uiuiiii1/stm32f407-iot-gateway/docs/工业网关项目开发计划.md

# 基于RTOS的多功能工业网关 — 完整开发计划

> 本文档面向开发者与AI助手，包含全部器件清单、用途、接线方案、分阶段开发步骤与验证标准。
> 主控：STM32F407VGT6（Cortex-M4F，168MHz，1MB Flash，192KB SRAM）
> 系统：FreeRTOS 多任务
>
> **v1.1修订说明（2026-09-29）**：修正DS1307供电电平（必须接5V）、TJA1050电平说明（按数据手册VIH≥2.0V，可直连）、SD卡容量说法、内部Flash分区止址（1MB实际到0x080FFFFF）；修正FreeRTOS队列双消费者设计、SPI互斥锁范围、OTA双槽回滚、Flash写指针磨损方案；新增补购器件清单（B1~B5）、CubeMX关键设置（Serial Wire调试、HAL时基移TIM）、W5500/FreeRTOS整合坑、断网缓存容量与寿命核算；时间估算整体上调。

---

## 第一部分：器件清单与用途

### 一、已购全部器件（18项）

| 编号 | 器件名称 | 型号/规格 | 数量 | 核心用途 | 接口类型 |
|---|---|---|---|---|---|
| M1 | 主控核心板 | STM32F407VGT6（排针已焊） | 1 | 运行FreeRTOS，处理所有协议与任务 | — |
| M2 | 显示屏 | 1.54寸 TFT（配套核心板，SPI接口） | 1 | 本地显示IP、温湿度、运行状态、数据曲线 | SPI |
| M3 | 以太网模块 | W5500（普通版，硬件TCP/IP协议栈） | 1 | 接路由器，TCP/MQTT上传数据到云端 | SPI |
| M4 | RS485收发模块 | ZY-SP3485（3.3V） | 1 | 主控TTL电平 ↔ RS485差分信号转换 | UART + GPIO |
| M5 | 温湿度变送器 | 导轨式 RS485 Modbus RTU（SHT30方案） | 1 | 采集真实温湿度数据，作为Modbus从站 | RS485总线 |
| M6 | RTC时钟模块 | DS1307（带电池，I2C接口） | 1 | 为每条采集数据打时间戳，掉电持续走时（**VCC必须接5V**，见M6详述） | I2C |
| M7 | 外部Flash | W25Q64（8MB，SPI接口） | 1 | 断网数据缓存 + OTA固件备份存储 | SPI |
| M8 | USB转TTL | CH340模块 | 1 | 程序下载/串口调试，连接电脑与主控UART | UART（USB端） |
| M9 | 杜邦线 | 公对母/母对母 | 1扎 | 模块间接线 | — |
| M10 | 面包板 | 830孔 | 1块 | 临时搭建电路，模块互连 | — |
| M11 | 电源适配器 | 5V 2A | 1个 | 整套系统供电（阶段0~10够用；做4G双链路时建议换5V 3A，见补购B5） | DC |
| M12 | 网线 | 超五类 | 1根 | W5500连接路由器或电脑 | RJ45 |
| M13 | 120Ω电阻 | 1/4W 1%金属膜 | 2个 | CAN/RS485总线终端电阻（阻抗匹配） | 直插 |
| M14 | CAN收发器 | TJA1050模块 | 1 | 主控CAN外设 ↔ CAN差分总线转换（可选扩展） | CAN + GPIO |
| M15 | USB转RS485 | CH340方案（无隔离基础款） | 1 | 电脑端直接发Modbus指令调试温湿度变送器 | USB（电脑端） |
| M16 | SD卡模块 | 5V版（带电平转换，支持SDHC） | 1 | 大量历史数据本地存储（数据黑匣子，可选） | SPI |
| M17 | SD卡 | 8G/16G Class10（FAT32格式） | 1张 | 配合SD卡模块存储历史采集数据 | — |
| M18 | 4G模块 | Air780E开发板 | 1 | 无以太网时4G上云，双链路备份（可选扩展） | UART |

### 二、还需补购的器件（未购，v1.1新增）

| 编号 | 器件 | 参考价 | 必要性 | 用途 |
|---|---|---|---|---|
| B1 | ST-Link V2调试器（或DAPLink） | ¥20~30 | **必买** | SWD下载+在线调试。没有它无法设断点、无法查任务栈水位（uxTaskGetStackHighWaterMark），FreeRTOS整合阶段（阶段8）基本靠猜 |
| B2 | 逻辑分析仪（24MHz/8通道入门款即可） | ¥30~60 | 强烈推荐 | 抓SPI/I2C/RS485波形，定位DE/RE切换时序、SPI共享总线仲裁问题，一次投入全程受益 |
| B3 | DS3231 RTC模块 | ¥10~15 | 可选备件 | DS1307模块5V供电仍异常时直接替换（精度还高一个数量级） |
| B4 | 物联网SIM卡（移动/电信流量卡即可） | 按需 | 阶段13需要 | Air780E 4G上云 |
| B5 | 5V 3A电源适配器 | ¥15 | 阶段13需要 | 4G射频发射峰值1~2A，2A适配器余量不足 |

> 已购器件使用前核对：SP3485/W5500/W25Q64/TFT屏为3.3V器件；SD卡模块为5V版；**DS1307模块按5V接线（见M6修正）**；变送器5~28V宽压接5V。**温湿度变送器的Modbus寄存器地址表务必开工前向商家索要，没有它阶段3无法解析数据。**

### 三、各器件详细用途说明

#### M1 STM32F407VGT6 核心板
- **定位**：整个系统的大脑，运行FreeRTOS实时操作系统
- **关键资源**：1MB Flash（存Bootloader+应用+OTA备份）、192KB SRAM（任务栈+缓冲区）、3路SPI、3路UART、2路I2C、1路CAN、1路FSMC
- **板载资源**：Type-C供电口、复位按键、BOOT选择按键、LCD接口座、引出全部IO引脚
- **注意**：BOOT0接GND为正常Flash启动，BOOT0接3.3V为ISP串口下载模式

#### M2 1.54寸 TFT 显示屏
- **定位**：本地人机界面，替代原计划的0.96寸OLED
- **典型参数**：240×240分辨率，ST7789或ST7735驱动IC，SPI接口，65K色（RGB565）
- **显示内容规划**：
  - 第1行：系统标题 + 运行状态（在线/离线/采集中）
  - 第2行：IP地址
  - 第3行：温度值 + 单位
  - 第4行：湿度值 + 单位
  - 第5行：RTC时间
  - 第6行：网络状态 + 缓存数据条数
- **接口引脚**：BL（背光）、CS（片选）、DC（数据/命令选择）、SDA（MOSI）、SCL（SCK）、RST（复位）、GND、VCC（3.3V）

#### M3 W5500 以太网模块
- **定位**：硬件TCP/IP协议栈，减轻MCU负担，实现联网上云
- **关键特性**：全硬件TCP/IP（TCP/UDP/ICMP/IPv4/ARP），8个独立Socket，SPI接口，3.3V供电
- **用途**：通过MQTT或HTTP协议将采集的温湿度数据上传到云端服务器（如阿里云IoT、腾讯云IoT、或自建MQTT broker）
- **注意**：W5500芯片是3.3V器件（常见模块板载LDO可接受5V输入，按实物确认，严禁把5V直接接到芯片侧引脚）；SPI速率策略：初始化先降到3MHz以下，读到版本寄存器VERSIONR（0x0019）=0x04确认SPI链路正常后再逐步提速；**面包板+杜邦线走线下14MHz左右是实际稳定上限，80MHz只适合PCB短走线，本项目按14MHz封顶**

#### M4 SP3485 RS485收发模块
- **定位**：TTL电平 ↔ RS485差分信号的转换桥梁
- **关键引脚**：VCC（3.3V）、GND、TX（接MCU RX）、RX（接MCU TX）、DE/RE（收发方向控制，接MCU GPIO）
- **工作模式**：
  - DE=1, RE=1 → 发送模式（MCU向总线发数据）
  - DE=0, RE=0 → 接收模式（MCU从总线收数据）
- **注意**：必须买3.3V版本，5V的MAX485与F407电平不匹配

#### M5 温湿度变送器（RS485 Modbus RTU从站）
- **定位**：真实工业传感器，提供温湿度数据源
- **通信协议**：Modbus RTU，作为从站响应主站（网关）的读寄存器指令
- **典型寄存器**（需向商家确认具体地址表）：
  - 温度寄存器：通常地址0x0000，值=实际温度×10（如25.5℃→0x00FF=255）
  - 湿度寄存器：通常地址0x0001，值=实际湿度×10
- **供电**：5~28V宽压，项目中接5V
- **默认参数**：波特率9600，数据位8，停止位1，无校验，从站地址0x01（需向商家确认）

#### M6 DS1307 RTC时钟模块
- **定位**：实时时钟，为采集数据提供精确时间戳
- **关键特性**：I2C接口，7位地址0x68（8位写0xD0/读0xD1），带CR2032电池掉电走时，BCD码计时
- **用途**：每条温湿度数据附带年月日时分秒，断网缓存时按时间排序，联网补传时按时间顺序发送
- **⚠️ 供电修正（v1.1）**：**模块VCC必须接5V，不能接3.3V**。DS1307手册规定VCC=4.5~5.5V，且VCC低于约1.25×VBAT（CR2032为3V，即约3.75V）时芯片进入电池备份模式、I2C完全无响应。F407的PB6/PB7是FT（5V tolerant）引脚，模块上拉到5V的I2C总线可直接连接，无需电平转换。
- **注意**：DS1307精度一般（月误差±几分钟），项目够用；I2C上拉电阻模块通常已自带。若模块5V供电仍工作异常，换DS3231模块（3.3V/5V通用、温补晶振年误差约1分钟、寄存器与DS1307高度相似，见补购清单B3）

#### M7 W25Q64 外部Flash
- **定位**：8MB串行Flash，用于数据持久化存储
- **分区规划**（v1.1与阶段10双槽方案对齐）：
  - 扇区0（4KB）：配置参数区（云端地址、设备ID、波特率等）
  - 扇区1~255（约1MB）：断网数据缓存区（循环写入，磨损均衡）
  - 扇区256~383（512KB）：OTA新固件下载区
  - 扇区384~511（512KB）：OTA旧固件备份区（升级前备份当前应用，用于回滚）
  - 扇区512~2047（约6MB）：预留扩展（可借给数据缓存区扩容）
- **关键特性**：SPI接口，24位地址，扇区擦除（4KB），页编程（256字节），JEDEC ID 0xEF4017
- **注意**：W25Q64是3.3V器件

#### M8 CH340 USB转TTL
- **定位**：电脑与主控之间的串口通信桥梁
- **用途**：
  - 程序下载（配合FlyMcu或Keil的ISP下载）
  - 串口调试打印（printf输出运行日志、变量值、错误信息）
- **接线**：CH340 TXD → 主控 UART1 RX（PA10），CH340 RXD → 主控 UART1 TX（PA9），GND共地
- **注意**：TX/RX要交叉连接；CH340的3.3V/5V输出不要给整个系统供电，仅做信号

#### M14 TJA1050 CAN收发器
- **定位**：CAN控制器（F407片上bxCAN）↔ CAN差分总线的物理层转换
- **关键引脚**：VCC（5V）、GND、TXD（接MCU CAN_TX）、RXD（接MCU CAN_RX）、CANH、CANL
- **用途**：可选扩展，采集CAN总线设备数据（如汽车OBD、工业PLC），车企/工控方向常见应用
- **注意**：TJA1050是5V供电；其TXD输入为TTL电平（数据手册VIH≥2.0V），F407的3.3V推挽输出可直接驱动；RXD输出高电平接近5V，接PA11——F407的FT（5V tolerant）引脚，可直接连接，无需电平转换；总线两端各接120Ω终端电阻

#### M16 SD卡模块（5V版）
- **定位**：大容量本地存储，用于"数据黑匣子"功能
- **关键特性**：5V供电（板载电平转换芯片），SPI接口，支持SDHC卡（≤32GB）
- **用途**：存储历史采集数据，可按天/按文件存储，支持FatFS文件系统
- **注意**：本项目用5V版模块（板载LDO+电平转换），按5V接线最稳妥；SD/SDHC卡本身一律是3.3V信号，"≤2GB的SD卡与2~32GB的SDHC"只是卡容量规格差异、与模块供电无关（v1.1修正）；SD卡必须格式化为FAT32（FatFS默认不支持exFAT，除非开启FF_FS_EXFAT）

#### M18 Air780E 4G模块
- **定位**：以太网不可用时的备用上云通道，双链路冗余
- **关键特性**：Cat.1 bis，UART AT指令控制，支持MQTT/TCP/HTTP，需要物联网SIM卡
- **供电**：射频发射峰值1~2A，不能靠开发板USB供电；建议整机换5V 3A适配器（见补购B5），模块电源引脚就近并联≥470µF电容——供电不足的典型症状是MQTT连上后反复掉线重启
- **用途**：检测到W5500网络断开且持续无法恢复时，自动切换到4G链路上传数据
- **注意**：4G模块是可选高级功能，项目后期再做；需要单独购买物联网SIM卡（移动/电信）

---

## 第二部分：硬件连接方案

### 一、主控引脚分配总表

| 外设 | 功能 | MCU引脚 | 备注 |
|---|---|---|---|
| **UART1** | 调试串口（接CH340） | PA9(TX), PA10(RX) | printf调试输出 |
| **UART2** | RS485（接SP3485） | PA2(TX), PA3(RX) | Modbus RTU主站 |
| **UART2_DIR** | RS485收发方向控制 | PA4 | 高=发送，低=接收 |
| **UART3** | 4G模块（接Air780E） | PB10(TX), PB11(RX) | 可选，后期使用 |
| **SPI1** | W5500以太网 | PA5(SCK), PA6(MISO), PA7(MOSI) | 硬件TCP/IP |
| **SPI1_CS_W5500** | W5500片选 | PC4 | 低有效 |
| **SPI1_RST_W5500** | W5500复位 | PC5 | 低复位 |
| **SPI1_INT_W5500** | W5500中断 | PB0 | 可选，用于Socket事件通知 |
| **SPI2** | W25Q64 Flash | PB13(SCK), PB14(MISO), PB15(MOSI) | 外部存储 |
| **SPI2_CS_FLASH** | W25Q64片选 | PB12 | 低有效 |
| **SPI3** | 1.54寸TFT屏 | PB3(SCK), PB4(MISO), PB5(MOSI) | 显示输出 |
| **SPI3_CS_LCD** | TFT屏片选 | PA15 | 低有效 |
| **LCD_DC** | TFT数据/命令选择 | PB6 | 低=命令，高=数据 |
| **LCD_RST** | TFT复位 | PB7 | 低复位 |
| **LCD_BL** | TFT背光控制 | PB8 | 高=背光开 |
| **I2C1** | DS1307 RTC | PB8(SCL), PB9(SDA) | 实时时钟 |
| **CAN1** | TJA1050 CAN收发器 | PA11(RX), PA12(TX) | 可选扩展 |
| **LED** | 板载/外接状态LED | PC13 | 心跳指示灯 |
| **KEY** | 用户按键 | PC0 | 可选，手动触发补传/配网 |

> **注意**：PB8同时被LCD_BL和I2C1_SCL占用，需要调整。将I2C1改为PB6(SCL)/PB7(SDA)，LCD_BL改为PB9。修正后的引脚分配见下方最终版。

### 二、修正后的最终引脚分配（无冲突）

| 外设 | 功能 | MCU引脚 | 方向 |
|---|---|---|---|
| UART1 | 调试串口 | PA9(TX), PA10(RX) | 复用 |
| UART2 | RS485 | PA2(TX), PA3(RX) | 复用 |
| UART2_DIR | RS485方向控制 | PA4 | 输出 |
| UART3 | 4G模块（可选） | PB10(TX), PB11(RX) | 复用 |
| SPI1 | W5500 | PA5(SCK), PA6(MISO), PA7(MOSI) | 复用 |
| W5500_CS | 片选 | PC4 | 输出 |
| W5500_RST | 复位 | PC5 | 输出 |
| W5500_INT | 中断（可选） | PB0 | 输入 |
| SPI2 | W25Q64 + SD卡 | PB13(SCK), PB14(MISO), PB15(MOSI) | 复用 |
| FLASH_CS | W25Q64片选 | PB12 | 输出 |
| SD_CS | SD卡片选 | PC6 | 输出 |
| SPI3 | 1.54寸TFT | PB3(SCK), PB4(MISO未用), PB5(MOSI) | 复用 |
| LCD_CS | 屏片选 | PA15 | 输出 |
| LCD_DC | 数据/命令 | PB6 | 输出 |
| LCD_RST | 屏复位 | PB7 | 输出 |
| LCD_BL | 背光 | PB8 | 输出 |
| I2C1 | DS1307 | PB8(SCL), PB9(SDA) → **冲突！** | — |

> **再次修正**：PB8被LCD_BL占用，I2C1不能用PB8/PB9。
> **最终方案**：I2C1 使用 PB6(SCL)/PB7(SDA)，LCD_DC 改用 PC7，LCD_RST 改用 PC8，LCD_BL 改用 PC9。

### 三、最终无冲突引脚分配（请以此为准）

| 外设 | 功能 | MCU引脚 | 方向 | 说明 |
|---|---|---|---|---|
| **UART1** | 调试串口（CH340） | PA9(TX), PA10(RX) | AF7 | printf日志 |
| **UART2** | RS485（SP3485） | PA2(TX), PA3(RX) | AF7 | Modbus主站 |
| RS485_DIR | 收发方向控制 | PA4 | OUT | 1=发,0=收 |
| **UART3** | 4G模块（Air780E） | PB10(TX), PB11(RX) | AF7 | 可选/后期 |
| **SPI1** | W5500以太网 | PA5(SCK),PA6(MISO),PA7(MOSI) | AF5 | 硬件TCP/IP |
| W5500_CS | 片选 | PC4 | OUT | 低有效 |
| W5500_RST | 复位 | PC5 | OUT | 低复位 |
| W5500_INT | 中断 | PB0 | IN | 可选 |
| **SPI2** | W25Q64 + SD卡 | PB13(SCK),PB14(MISO),PB15(MOSI) | AF5 | 共用总线 |
| FLASH_CS | W25Q64片选 | PB12 | OUT | 低有效 |
| SD_CS | SD卡片选 | PC6 | OUT | 低有效 |
| **SPI3** | 1.54寸TFT屏 | PB3(SCK),PB5(MOSI) | AF6 | MISO可不接 |
| LCD_CS | 屏片选 | PA15 | OUT | 低有效 |
| LCD_DC | 数据/命令选择 | PC7 | OUT | 0=命令,1=数据 |
| LCD_RST | 屏复位 | PC8 | OUT | 低复位 |
| LCD_BL | 背光控制 | PC9 | OUT | 1=开 |
| **I2C1** | DS1307 RTC | PB6(SCL), PB7(SDA) | AF4 | 7位地址0x68；**模块VCC接5V**（PB6/PB7为FT引脚可承受） |
| **CAN1** | TJA1050（可选） | PA11(RX), PA12(TX) | AF9 | 车企加分 |
| LED | 心跳灯 | PC13 | OUT | 板载LED |
| KEY | 用户按键 | PC0 | IN | 可选 |

> **⚠️ CubeMX必设项（v1.1新增）**：SYS → Debug 必须选 **Serial Wire**。默认状态下PB3/PB4是JTAG的JTDO/NJTRST，不释放的话SPI3的TFT屏怎么调都不出图；且只有选了Serial Wire才能用ST-Link下载与断点调试。

### 四、各模块详细接线表

#### 1. CH340 USB转TTL ↔ STM32（调试串口）

| CH340引脚 | STM32引脚 | 说明 |
|---|---|---|
| GND | GND | 共地（必须） |
| TXD | PA10（UART1_RX） | 交叉连接 |
| RXD | PA9（UART1_TX） | 交叉连接 |
| 3.3V/5V | **不接** | 不要用CH340给系统供电 |

#### 2. SP3485 ↔ STM32 ↔ 温湿度变送器

| SP3485引脚 | STM32引脚 | 说明 |
|---|---|---|
| VCC | 3.3V | 3.3V供电（关键！不要接5V） |
| GND | GND | 共地 |
| TX | PA3（UART2_RX） | SP3485发送→MCU接收 |
| RX | PA2（UART2_TX） | MCU发送→SP3485接收 |
| DE/RE | PA4 | 方向控制，短接在一起 |

| 温湿度变送器 | SP3485侧 | 说明 |
|---|---|---|
| VCC+ | 5V | 变送器5~28V宽压，接5V |
| GND | GND | 共地 |
| 485A | A | RS485 A线 |
| 485B | B | RS485 B线 |

> **RS485总线终端电阻**：仅1个从站、线短（<1m）时可不接；长距离时在总线两端各接1个120Ω（A-B之间）。

#### 3. W5500 ↔ STM32

| W5500引脚 | STM32引脚 | 说明 |
|---|---|---|
| VCC | 3.3V | 3.3V供电（关键！不要接5V） |
| GND | GND | 共地 |
| SCK | PA5（SPI1_SCK） | SPI时钟 |
| MISO | PA6（SPI1_MISO） | 主入从出 |
| MOSI | PA7（SPI1_MOSI） | 主出从入 |
| CS | PC4 | 片选，低有效 |
| RST | PC5 | 复位，低有效 |
| INT | PB0 | 中断输出（可选，不接也能用） |

#### 4. W25Q64 ↔ STM32

| W25Q64引脚 | STM32引脚 | 说明 |
|---|---|---|
| VCC | 3.3V | 3.3V供电 |
| GND | GND | 共地 |
| CLK | PB13（SPI2_SCK） | SPI时钟 |
| DO(MISO) | PB14（SPI2_MISO） | 数据输出 |
| DI(MOSI) | PB15（SPI2_MOSI） | 数据输入 |
| CS | PB12 | 片选，低有效 |
| WP/HOLD | 3.3V | 接高电平，不使用写保护/暂停 |

#### 5. SD卡模块（5V版）↔ STM32

| SD卡模块引脚 | STM32引脚 | 说明 |
|---|---|---|
| VCC | 5V | 5V供电（模块自带电平转换） |
| GND | GND | 共地 |
| SCK | PB13（SPI2_SCK） | 与W25Q64共用SCK |
| MISO | PB14（SPI2_MISO） | 与W25Q64共用MISO |
| MOSI | PB15（SPI2_MOSI） | 与W25Q64共用MOSI |
| CS | PC6 | 独立片选，低有效 |

> **SPI2总线**：W25Q64和SD卡共用SCK/MISO/MOSI，通过不同CS引脚区分。同一时刻只能有一个设备CS为低。

#### 6. 1.54寸 TFT屏 ↔ STM32

| TFT屏引脚 | STM32引脚 | 说明 |
|---|---|---|
| VCC | 3.3V | 3.3V供电 |
| GND | GND | 共地 |
| SCL | PB3（SPI3_SCK） | SPI时钟 |
| SDA | PB5（SPI3_MOSI） | 数据输入（TFT只收不发） |
| CS | PA15 | 片选，低有效 |
| DC | PC7 | 0=发命令，1=发数据 |
| RST | PC8 | 复位，低有效 |
| BL | PC9 | 背光控制，1=开 |

> 注意：TFT屏的MISO引脚通常不需要接（屏只接收数据不发送），如果屏上有此引脚可悬空。

#### 7. DS1307 RTC ↔ STM32

| DS1307引脚 | STM32引脚 | 说明 |
|---|---|---|
| VCC | 5V | **必须接5V**（DS1307手册VCC=4.5~5.5V；接3.3V时芯片因掉电检测阈值进入电池模式，I2C无响应） |
| GND | GND | 共地 |
| SCL | PB6（I2C1_SCL） | I2C时钟 |
| SDA | PB7（I2C1_SDA） | I2C数据 |

> DS1307模块通常已自带4.7K上拉电阻（上拉到模块VCC=5V；PB6/PB7为FT引脚，可承受5V总线电平，无需电平转换）。I2C 7位地址0x68（8位写0xD0/读0xD1）。

#### 8. TJA1050 CAN收发器 ↔ STM32（可选）

| TJA1050引脚 | STM32引脚 | 说明 |
|---|---|---|
| VCC | 5V | 5V供电 |
| GND | GND | 共地 |
| TXD | PA12（CAN1_TX） | MCU发送 |
| RXD | PA11（CAN1_RX） | MCU接收 |
| CANH | CAN总线H | 接CAN总线 |
| CANL | CAN总线L | 接CAN总线 |
| S | GND | 工作模式（接地=正常模式） |

> CAN总线两端各接1个120Ω终端电阻（CANH-CANL之间）。仅两个节点时两个节点各焊一颗。

#### 9. Air780E 4G模块 ↔ STM32（可选/后期）

| Air780E引脚 | STM32引脚 | 说明 |
|---|---|---|
| VCC | 5V（建议整机3A适配器，模块就近并联≥470µF电容） | 射频发射峰值1~2A，供电不足会反复掉线重启 |
| GND | GND | 共地 |
| TXD | PB11（UART3_RX） | 模块发送→MCU接收 |
| RXD | PB10（UART3_TX） | MCU发送→模块接收 |
| PWR_KEY | GPIO（如PC10） | 开机控制（拉低2秒开机） |
| RESET | GPIO（如PC11） | 复位（可选） |

> Air780E需要插入物联网SIM卡，默认波特率115200。

### 五、供电方案

```
5V 2A电源适配器
    ├── 5V → 温湿度变送器 VCC
    ├── 5V → SD卡模块 VCC
    ├── 5V → TJA1050 VCC
    ├── 5V → Air780E VCC（独立供电，峰值1A）
    └── 5V → STM32核心板 Type-C或5V引脚（板载AMS1117转3.3V）
                                          ├── 3.3V → W5500 VCC
                                          ├── 3.3V → SP3485 VCC
                                          ├── 3.3V → W25Q64 VCC
                                          ├── 3.3V → DS1307 VCC
                                          ├── 3.3V → TFT屏 VCC
                                          └── 3.3V → 各模块上拉电阻
```

> **关键**：所有模块GND必须连在一起（共地），否则通信异常。5V 2A电源是必须的，USB供电电流不够。
> **v1.1补充**：W5500的3.3V由核心板同一颗AMS1117提供——单LDO供电天然规避了VDD/VDDA分路LDO上电时序不一致引起的W5500冷启动概率性初始化失败，这个接法不要改成模块独立供电。阶段0~10用2A适配器足够，做阶段13（4G）时换5V 3A（补购B5）。

---

## 第三部分：开发环境搭建

### 一、软件清单

| 软件 | 用途 | 版本建议 | 下载来源 |
|---|---|---|---|
| Keil MDK-ARM | 代码编写、编译、调试 | V5.38或V5.39 | Keil官网（需注册License） |
| STM32CubeMX | 图形化配置GPIO/外设/时钟，生成初始化代码 | 最新版 | ST官网 |
| STM32CubeF4固件库 | F4系列HAL库/标准外设库 | 最新版 | ST官网 |
| FlyMcu | 串口ISP下载程序 | V0.188 | 网上搜索 |
| 串口助手 | 调试串口打印 | XCOM或SSCOM | 网上搜索 |
| Modbus Poll / 串口调试助手 | 电脑端通过USB转RS485发Modbus指令测试变送器 | Modbus Poll | 网上搜索 |
| MQTTX（或MQTT.fx 1.7） | 电脑端MQTT客户端，模拟云端接收数据 | MQTTX免费开源，推荐 | EMQ官网/GitHub |
| 文本编辑器 | 查看/编辑代码 | VS Code | 微软官网 |

### 二、Keil工程创建步骤

1. 打开STM32CubeMX，新建项目，选择MCU为STM32F407VGTx
2. 配置系统时钟：HSE（外部晶振，通常8MHz或25MHz，看核心板原理图），PLL倍频至168MHz
3. 按"最终无冲突引脚分配表"配置每个外设的GPIO和复用功能；**SYS → Debug 必须选 Serial Wire**（否则PB3/PB4被JTAG占用，SPI3的TFT屏不工作，也无法用ST-Link在线调试）
4. 配置UART1：115200波特率，8数据位，1停止位，无校验
5. 配置UART2：9600波特率（匹配温湿度变送器默认值），8N1
6. 配置SPI1：主机模式，8位，CPOL=Low, CPHA=1Edge（W5500要求Mode0），预分频器初始设为64（2.625MHz），稳定后改2（42MHz）
7. 配置SPI2：主机模式，8位，Mode0，预分频器初始64
8. 配置SPI3：主机模式，8位，Mode0，预分频器初始64
9. 配置I2C1：标准模式100kHz或快速模式400kHz
10. 配置CAN1：500kbps（常用），工作模式正常
11. 配置GPIO输出：各CS、RST、DC、BL、DIR、LED
12. 生成代码（选择MDK-ARM V5）
13. 在Keil中打开生成的工程，添加FreeRTOS源码
14. 配置工程选项：C/C++ → Define 添加 USE_HAL_DRIVER, STM32F407xx；Optimization选-O1（调试阶段选-O0）
15. Debug → 选择ST-Link或J-Link（如果用调试器），或用FlyMcu串口下载

### 三、程序下载方式

| 方式 | 所需硬件 | 步骤 |
|---|---|---|
| ST-Link调试器 | ST-Link V2 | SWD接口（SWDIO=PA13, SWCLK=PA14），Keil直接下载+调试 |
| 串口ISP下载 | CH340 + FlyMcu | BOOT0接3.3V→复位→FlyMcu下载→BOOT0接GND→复位运行 |
| DAPLink | DAPLink调试器 | 同ST-Link，SWD接口 |

> 推荐：如果有ST-Link或DAPLink，用SWD下载，可以在线调试（设断点、看变量）。只有CH340的话用串口ISP下载，不能在线调试。

---

## 第四部分：分阶段开发计划

### 总体原则
- 从易到难，每一步先验证通过再进入下一步
- 每完成一个模块，保存一个可工作的工程备份
- 先裸机调通每个外设，再移植FreeRTOS整合
- 先核心功能（采集+显示+上传），后高级功能（缓存+OTA+4G+CAN）

---

### 阶段0：硬件验证与点灯（预计0.5天）

**目标**：确认核心板能正常下载程序、运行、串口输出。

**操作步骤**：
1. 核心板插Type-C供电（或5V引脚），确认电源灯亮
2. CH340接UART1（PA9/PA10），插电脑，确认设备管理器出现COM口
3. CubeMX生成最简工程（只配UART1 + GPIO PC13输出 + 系统时钟）
4. 在main.c中添加：LED闪烁（500ms周期）+ printf("System Start\r\n")
5. 编译、下载、运行
6. 串口助手收到"System Start"，LED闪烁 → 验证通过

**验证标准**：
- [ ] 程序能正常下载
- [ ] LED按预期闪烁
- [ ] 串口能收到printf输出
- [ ] 复位后重新运行正常

**常见问题**：
- 串口收不到：检查TX/RX是否交叉、GND是否共地、波特率是否一致
- 程序下载失败：检查BOOT0位置、CH340驱动、串口是否被占用

---

### 阶段1：1.54寸TFT屏显示（预计1天）

**目标**：屏幕能显示文字、数字、颜色填充。

**操作步骤**：
1. 按接线表连接TFT屏（SPI3：PB3/PB5，CS=PA15，DC=PC7，RST=PC8，BL=PC9）
2. 确认屏的驱动IC：查看商家资料，常见为ST7789（240×240）或ST7735（128×128/128×160）
3. 添加对应驱动文件（lcd.c/lcd.h），实现：
   - `LCD_Init()`：初始化序列（复位→发送初始化命令→开显示）
   - `LCD_Clear(color)`：全屏填充
   - `LCD_DrawPoint(x,y,color)`：画点
   - `LCD_ShowChar(x,y,ch,color,bg,size)`：显示单个ASCII字符
   - `LCD_ShowString(x,y,str,color,bg,size)`：显示字符串
   - `LCD_ShowNum(x,y,num,len,color,bg,size)`：显示数字
4. 字模数据：使用PCtoLCD2002取模软件生成ASCII字模（16×8或24×12），存入font.c
5. main.c中测试：清屏→显示"Gateway Test"→显示数字12345→显示IP"192.168.1.100"
6. 编译下载，观察屏幕

**验证标准**：
- [ ] 屏幕背光点亮
- [ ] 全屏填充颜色正常（无花屏、无偏移）
- [ ] 英文字符显示清晰、位置正确
- [ ] 数字显示正确
- [ ] 多次刷新不出现残影或错位

**常见问题**：
- 屏幕不亮：检查BL引脚是否拉高、VCC是否3.3V
- 花屏/白屏：SPI速率太高（降低预分频器）、RST时序不对、初始化命令不对
- 颜色反转/偏移：确认驱动IC型号（ST7789 vs ST7735），不同IC的初始化命令和扫描方向不同
- 字符乱码：字模取模方式与显示函数不匹配（逐行式/逐列式、正序/倒序）

---

### 阶段2：DS1307 RTC时间读取（预计0.5天）

**目标**：能读取并设置当前时间，串口打印正确时间。

**操作步骤**：
1. 连接DS1307（I2C1：PB6/PB7，**模块VCC接5V**），插入CR2032电池
2. CubeMX配置I2C1：100kHz标准模式
3. 实现ds1307.c/ds1307.h：
   - `DS1307_Init()`：检查器件是否响应（读地址0x00）
   - `DS1307_SetTime(y,m,d,h,min,s)`：设置时间（BCD码转换）
   - `DS1307_GetTime(&time)`：读取时间
   - BCD↔十进制转换函数
4. main.c中：设置一个时间→循环读取→串口打印"2026-09-29 12:00:00"
5. 断电10秒再上电，确认时间继续走（电池备份生效）

**验证标准**：
- [ ] I2C能扫描到DS1307地址（0x68）
- [ ] 设置时间后读取值一致
- [ ] 时间每秒递增正确
- [ ] 掉电后时间不丢失（电池供电）

**常见问题**：
- I2C扫描不到设备：检查SDA/SCL是否接反、上拉电阻是否存在、模块VCC是否接的5V（接3.3V时DS1307进入电池模式、I2C无响应，这是本模块最常见故障）
- 时间不走：检查CH位（寄存器0x00的bit7）是否为0（0=振荡器开启）
- 时间值异常：BCD码没有正确转换（DS1307寄存器存的是BCD码，不是二进制）

---

### 阶段3：RS485 Modbus采集温湿度（预计1.5天）

**目标**：通过RS485读取温湿度变送器数据，解析出温度和湿度值。

**操作步骤**：

#### 3.1 先用USB转RS485在电脑端验证变送器（必做！）
1. USB转RS485插入电脑，安装CH340驱动
2. USB转RS485的A/B接温湿度变送器的A/B，变送器接5V电源
3. 打开Modbus Poll或串口调试助手
4. 发送读保持寄存器指令（需根据商家提供的寄存器表）：
   - 典型指令：`01 03 00 00 00 02 C4 0B`
     - 01=从站地址，03=功能码（读保持寄存器），0000=起始地址，0002=寄存器数量，C40B=CRC16
   - 预期回复：`01 03 04 00 FF 01 02 XX XX`（温度25.5℃，湿度25.8%为例）
5. 确认变送器能正常回复数据，记录：从站地址、波特率、温度寄存器地址、湿度寄存器地址、数据换算公式

#### 3.2 STM32端实现Modbus RTU主站
1. 连接SP3485（UART2：PA2/PA3，DIR=PA4）
2. CubeMX配置UART2：9600波特率（或变送器实际波特率），8N1
3. 实现modbus.c/modbus.h：
   - `MODBUS_SendRead(slave_addr, reg_addr, reg_num)`：组装读寄存器指令+CRC16，DE拉高→发送；**等UART的TC（Transmission Complete）标志置位后再拉低DE切回接收**——盲等固定延时容易截断最后1~2字节，是RS485最经典的偶发丢包原因
   - `MODBUS_Receive(buf, timeout)`：等待从站回复，超时返回错误
   - `CRC16(data, len)`：Modbus CRC16校验算法（多项式0xA001）
   - `MODBUS_ReadTempHum(&temp, &hum)`：完整流程：发指令→收回复→CRC校验→解析数据→换算实际值
4. 数据解析：
   - 温度值 = 寄存器值 / 10.0（如果是放大10倍存储）
   - 湿度值 = 寄存器值 / 10.0
5. main.c中：每2秒读一次温湿度，串口打印"Temp: 25.5C, Hum: 60.2%"

**验证标准**：
- [ ] USB转RS485电脑端能读到变送器数据（确认变送器本身正常）
- [ ] STM32能发出正确的Modbus指令（可用USB转RS485在电脑端监听）
- [ ] STM32能收到变送器回复
- [ ] CRC校验通过
- [ ] 解析出的温湿度值合理（与电脑端读到的一致）
- [ ] 连续读取10次无丢包、无异常值

**常见问题**：
- 收不到回复：DE/RE方向控制时序不对（发完指令要延迟一小段再切回接收）、A/B线接反、波特率不匹配
- CRC校验失败：字节丢失（波特率误差大）、接收缓冲区溢出、从站地址错误
- 数据异常：寄存器地址不对、数据大小端搞反、换算公式不对（必须以商家提供的寄存器表为准）
- 偶尔丢包：RS485总线没有终端电阻（长距离时）、发送间隔太短（至少间隔100ms）

---

### 阶段4：W25Q64 Flash读写（预计1天）

**目标**：能对W25Q64进行读ID、擦除、写数据、读数据操作。

**操作步骤**：
1. 连接W25Q64（SPI2：PB13/PB14/PB15，CS=PB12）
2. 实现w25q64.c/w25q64.h：
   - `W25Q64_ReadID()`：发送0x9F命令，读取JEDEC ID（应为0xEF4017）
   - `W25Q64_WriteEnable()`：发送0x06命令
   - `W25Q64_WaitBusy()`：读状态寄存器1（0x05），等待BUSY位清零
   - `W25Q64_SectorErase(addr)`：扇区擦除（0x20命令，4KB对齐）
   - `W25Q64_PageProgram(addr, data, len)`：页编程（0x02命令，≤256字节）
   - `W25Q64_ReadData(addr, buf, len)`：读数据（0x03命令）
3. main.c中测试：
   - 读ID，确认是0xEF4017
   - 擦除扇区0
   - 写入测试数据"Hello W25Q64"
   - 读回数据，串口打印对比
4. 实现简单的存储管理：
   - 定义数据结构体：`{uint32_t timestamp; float temp; float hum; uint8_t status;}` 约13字节
   - `Flash_SaveData(data)`：追加写入缓存区
   - `Flash_ReadData(index, &data)`：读取指定位置数据
   - `Flash_GetDataCount()`：获取缓存数据条数

**验证标准**：
- [ ] JEDEC ID读取正确（0xEF4017）
- [ ] 擦除后读取全0xFF
- [ ] 写入后读回数据一致
- [ ] 跨页写入正常（写入>256字节时自动分页）
- [ ] 掉电后数据不丢失
- [ ] 连续写入100条数据后读取全部正确

**常见问题**：
- ID读不到：SPI模式不对（W25Q64用Mode0）、CS时序不对、SPI速率太高
- 写入失败：没有先发Write Enable命令、没有等待Busy结束、地址没有页对齐
- 数据不对：地址计算错误、大小端问题

---

### 阶段5：W5500以太网联网（预计2天）

**目标**：W5500能获取IP（DHCP或静态），能Ping通，能建立TCP连接。

**操作步骤**：
1. 连接W5500（SPI1：PA5/PA6/PA7，CS=PC4，RST=PC5）
2. 网线连接W5500和路由器（或直连电脑）
3. 移植W5500驱动（ioLibrary库，WIZnet官方）：
   - `wizchip_init()`：初始化W5500，设置SPI读写回调函数
   - `wizchip_setnetinfo()`：设置MAC、IP、子网掩码、网关
   - `wizchip_getnetinfo()`：读取网络配置
   - Socket API：`socket()`、`connect()`、`send()`、`recv()`、`close()`
4. 网络配置（先用静态IP测试）：
   - MAC：02:00:00:00:00:01（自定义）
   - IP：192.168.1.100（与路由器同网段）
   - 子网掩码：255.255.255.0
   - 网关：192.168.1.1
5. 测试步骤：
   - 初始化W5500，读取PHY状态（确认网线已插）
   - 设置网络信息
   - 用电脑Ping 192.168.1.100，能通→网络层正常
   - 建立TCP连接到电脑的TCP服务器（如用网络调试助手），发送"Hello W5500"
   - 电脑端收到数据→TCP层正常
6. （可选）移植DHCP客户端，自动获取IP

**验证标准**：
- [ ] W5500初始化成功，SPI通信正常（读版本寄存器VERSIONR 0x0019，应返回0x04）
- [ ] PHY状态为LinkUp（网线已连接）
- [ ] 电脑能Ping通W5500的IP
- [ ] 能建立TCP连接
- [ ] 能发送和接收数据
- [ ] 断开网线后PHY状态变为LinkDown

**常见问题**：
- W5500初始化失败：SPI速率太高（初始降到1~3MHz）、RST拉低释放后需延时≥50ms再访问、CS控制不对；先读VERSIONR（0x0019应=0x04）确认SPI链路再谈别的
- Ping不通：IP/网关/子网掩码配置错误、网线没插好、路由器不在同网段
- TCP连不上：服务器IP/端口错误、防火墙拦截、Socket没有正确打开
- 连接后自动断开：没有处理中断/ keepalive、发送数据太快

---

### 阶段6：MQTT上云（预计1.5天）

**目标**：通过W5500将温湿度数据以MQTT协议上传到云端。

**操作步骤**：
1. 选择MQTT broker：
   - 测试用：EMQX公共服务器（broker.emqx.io:1883）
   - 生产用：阿里云IoT / 腾讯云IoT / 自建EMQX
2. 移植MQTT客户端库（paho-mqtt-embedded或mqttclient）：
   - `MQTTConnect()`：连接broker
   - `MQTTPublish(topic, payload)`：发布消息
   - `MQTTSubscribe(topic, callback)`：订阅主题（可选，用于远程控制）
   - `MQTTRun()`：保持连接，处理心跳和收到的消息
3. 数据格式（JSON）：
   ```json
   {"device_id":"gw001","temp":25.5,"hum":60.2,"timestamp":1727582400}
   ```
4. main.c中：每5秒采集一次温湿度→组装JSON→MQTT发布到主题"gateway/data"
5. 电脑端用MQTT.fx连接同一broker，订阅"gateway/data"，确认收到数据

**验证标准**：
- [ ] MQTT能连接到broker（CONNACK返回0）
- [ ] 能保持连接（心跳包正常，不会被broker踢下线）
- [ ] 发布的消息能在MQTT.fx中收到
- [ ] JSON数据格式正确，温湿度值准确
- [ ] 连续发布100条无丢失
- [ ] 断开网络后重连机制正常

**常见问题**：
- 连接失败：broker地址/端口错误、网络不通、ClientID重复
- 发布失败：没有先连接、topic格式不对、QoS级别不支持
- 数据乱码：JSON字符串组装错误、sprintf缓冲区溢出
- 频繁断线：心跳间隔太长、网络不稳定、没有实现重连逻辑

---

### 阶段7：TFT显示整合（预计0.5天）

**目标**：将之前调通的各模块数据整合显示到TFT屏上。

**操作步骤**：
1. 设计显示布局（240×240屏幕）：
   ```
   ┌─────────────────────┐
   │  Industrial Gateway │  标题（16号字）
   │  Status: ONLINE     │  状态（绿色=在线，红色=离线）
   │  IP: 192.168.1.100  │  IP地址
   │  Temp: 25.5 C       │  温度
   │  Hum:  60.2 %       │  湿度
   │  Time: 12:00:00     │  RTC时间
   │  Cache: 0  RX: 123  │  缓存数/已发送数
   └─────────────────────┘
   ```
2. 实现显示刷新函数：`Display_Update(temp, hum, ip, status, cache_count)`
3. 注意：不要全屏刷新（太慢），只刷新变化的区域（局部清屏+重写）
4. main.c中：每1秒刷新一次屏幕

**验证标准**：
- [ ] 所有信息显示完整、无重叠
- [ ] 温湿度数值实时更新
- [ ] 网络状态颜色变化正确
- [ ] 刷新时无明显闪烁

---

### 阶段8：移植FreeRTOS多任务（预计3~4天）

**目标**：将所有功能整合到FreeRTOS中，多任务并行运行。

**操作步骤**：
1. 移植FreeRTOS V10.x到Keil工程：
   - 添加源码：tasks.c、queue.c、list.c、timers.c、event_groups.c、heap_4.c、port.c
   - **把HAL时基移出SysTick**（CubeMX：SYS → Timebase Source 选TIM6/TIM7）：FreeRTOS要独占SysTick作节拍源，两者共用会出现HAL_GetTick不走、任务里HAL_Delay假死等诡异现象
   - 配置FreeRTOSConfig.h：
     - configCPU_CLOCK_HZ = 168000000
     - configTICK_RATE_HZ = 1000
     - configTOTAL_HEAP_SIZE = 60*1024（60KB，F407有192KB SRAM够用）
     - configMAX_PRIORITIES = 10
     - 使能configUSE_MUTEXES、configUSE_COUNTING_SEMAPHORES
2. 任务划分：

| 任务名 | 优先级 | 栈大小 | 功能 | 周期 |
|---|---|---|---|---|
| CollectTask | 5（高） | 512字 | RS485采集温湿度，数据放入队列 | 2秒 |
| NetworkTask | 4 | 1024字 | W5500 MQTT连接+发布数据 | 5秒 |
| DisplayTask | 3 | 512字 | TFT屏刷新显示 | 1秒 |
| StorageTask | 3 | 512字 | 断网时写Flash缓存，联网时补传 | 事件触发 |
| WatchdogTask | 6（最高） | 256字 | 喂独立看门狗，监控各任务心跳 | 1秒 |

> 栈大小单位是**字（word）**，Cortex-M上1字=4字节（512字=2KB、1024字=4KB）。上表为初始值，用uxTaskGetStackHighWaterMark()实测后回调。

3. 任务间通信（v1.1修正）：
   - 采集数据队列：`xQueueData`（CollectTask发，**NetworkTask作为唯一消费者**——FreeRTOS队列是出队模型，两个任务收同一个队列时每条数据只会被其中一个拿到，DisplayTask不能也从这里收）
   - 最新值共享变量：`xLatestData`（含temp/hum/timestamp，由`xDataMutex`保护；CollectTask写入、DisplayTask读取显示，与队列互不干扰）
   - 网络状态信号量/事件组：`xEventGroupNet`（bit0=网络在线，bit1=MQTT已连接）
   - 互斥锁：`xSPIMutex`（保护**SPI2**总线——W25Q64和SD卡分时复用；SPI1上只有W5500一个设备，不需要互斥）
4. 每个任务实现：
   - 任务初始化（外设初始化只做一次）
   - 任务主循环（vTaskDelayUntil精确周期）
   - 错误处理（通信失败重试、超时降级）
   - **任务内延时一律用vTaskDelay/vTaskDelayUntil、禁止HAL_Delay；需要关中断的临界区用taskENTER_CRITICAL()/taskEXIT_CRITICAL()——直接__disable_irq()会停掉SysTick，整个系统假死**
5. 看门狗：IWDG独立看门狗，超时2秒，WatchdogTask定期喂狗；每个任务设置心跳标志，WatchdogTask检查所有任务心跳，任一任务卡死超过5秒则不喂狗→系统复位

**验证标准**：
- [ ] FreeRTOS调度正常，所有任务都在运行
- [ ] 任务间数据传递正确（队列无丢失）
- [ ] SPI总线共享无冲突（互斥锁生效）
- [ ] 看门狗正常喂狗，不会意外复位
- [ ] 系统连续运行24小时无死机、无内存泄漏
- [ ] 用Keil查看任务栈使用情况，无栈溢出

**常见问题**：
- 任务栈溢出：增大栈大小，用uxTaskGetStackHighWaterMark()检查
- 系统卡死：优先级反转（用互斥锁）、死锁（检查锁的获取顺序）、中断优先级配置错误
- 整合后系统假死/HAL_GetTick不走：HAL时基与FreeRTOS共用SysTick（把时基移到TIM6/TIM7）；代码里直接__disable_irq()同样造成此现象
- W5500整合进RTOS后初始化失败/连不上：复位后延时≥50ms再访问；任务内等待一律osDelay/vTaskDelay；裸机阶段调通的SPI速率在加互斥锁后如不稳，先降回3MHz复测再提速
- 内存不足：减小configTOTAL_HEAP_SIZE或优化任务栈
- 中断不工作：FreeRTOS的中断优先级分组配置（NVIC_PRIORITYGROUP_4），优先级数值大于configMAX_SYSCALL_INTERRUPT_PRIORITY的中断才能调用FreeRTOS API

---

### 阶段9：断网缓存+联网补传（预计1.5天）

**目标**：网络断开时数据存入W25Q64，网络恢复后按时间顺序补传。

**操作步骤**：
1. 网络状态检测：
   - NetworkTask定期检查W5500 PHY状态和MQTT连接状态
   - 连续3次发布失败→判定为断网→设置事件标志位
2. 断网缓存逻辑（StorageTask）：
   - 检测到断网→将采集数据追加写入W25Q64缓存区
   - 缓存区采用循环写入（写满后从头部覆盖最旧数据）
   - **写指针/条数不要每次落盘到配置区**（v1.1修正）：4KB配置扇区擦写寿命约10万次，每2秒更新一次指针几天就磨穿。正确做法是上电扫描缓存区、按flag/CRC重建写指针与条数——NOR Flash擦后全0xFF、按字节编程的特性天然支持"追加+最后写标志"的日志式写入
3. 联网补传逻辑：
   - 检测到网络恢复→先补传缓存数据，再发实时数据
   - 补传按时间顺序从旧到新
   - 每条补传成功后更新读指针
   - 补传期间实时数据继续缓存（避免丢失）
4. 数据结构：
   ```c
   typedef struct {
       uint32_t timestamp;  // RTC时间戳（Unix时间）
       float temp;
       float hum;
       uint8_t flag;        // 提交标志：整条记录写完后最后才改写为0=有效（掉电写到一半的记录flag仍是0xFF，天然失效）
       uint8_t crc;         // 前12字节的CRC8：读出时校验，拦截半条记录/位翻转的脏数据
   } DataRecord_t;  // 14字节，按4字节对齐占16字节
   ```
5. 磨损均衡：缓存区固定为Flash的特定扇区范围，循环使用
6. 容量与寿命核算（v1.1新增）：
   - 容量：缓存区1MB ÷ 16字节/条 ≈ 6.5万条；2秒采样≈4.3万条/天，**满缓存仅支撑断网约1.5天**。需要更长容忍度：从预留区再借2MB给缓存（≈4.5天），或断网时自动降为10秒/条（≈7天）
   - 磨损：循环写满一轮≈1.5天，每个4KB扇区约1.5天擦除一次，按10万次寿命算可用≈400年，循环写入方案本身磨损无忧
   - 掉电安全：NOR Flash先擦后写、擦除中掉电该扇区数据全丢——靠"flag最后写+CRC校验"把损坏范围限制在正在写的1条内，重启扫描剔除即可

**验证标准**：
- [ ] 拔网线后数据正常写入Flash（不丢失）
- [ ] 插网线后缓存数据按时间顺序补传
- [ ] 补传完成后实时数据恢复正常发送
- [ ] 缓存区写满后循环覆盖（不越界）
- [ ] 掉电后缓存数据不丢失，上电继续补传
- [ ] 补传期间新采集的数据不丢失
- [ ] 写入中途断电/复位，重启后扫描重建正确：除正在写的一条外其余数据完好，补传顺序正确

---

### 阶段10：OTA远程升级（预计4~5天）

**目标**：通过网络下载新固件到W25Q64，校验后切换运行，支持回滚。

**操作步骤**：

#### 10.1 Flash分区规划
```
0x08000000 ──────────────
           │ Bootloader  │  32KB（0x08000000~0x08007FFF）
0x08008000 ──────────────
           │ 应用程序A   │  480KB（0x08008000~0x0807FFFF）
0x08080000 ──────────────
           │ 预留512KB   │  0x08080000~0x080FFFFF（可作第二应用槽/参数区）
0x080FFFFF ──────────────  ← F407VGT6 Flash结束（共1MB；v1.1修正：原文止于0x08080000，少算一半）
           
W25Q64外部Flash：
0x00000000 ──────────────
           │ 配置参数区  │  4KB
0x00001000 ──────────────
           │ 数据缓存区  │  约1MB
0x00100000 ──────────────
           │ 新固件下载区 │  512KB（0x00100000~0x0017FFFF）
0x00180000 ──────────────
           │ 旧固件备份区 │  512KB（0x00180000~0x001FFFFF，升级前备份当前应用）
0x00200000 ──────────────
           │ 预留扩展区   │  约6MB（可借给数据缓存区扩容）
0x00800000 ──────────────
```

#### 10.2 Bootloader开发
- 独立工程，运行在0x08000000
- 功能：
  - 检查W25Q64中是否有新固件（标志位+固件大小+CRC）
  - 有新固件→校验CRC→**先把当前应用备份到W25Q64旧固件区**→写入内部Flash应用区→清除标志→跳转应用
  - 无新固件→直接跳转应用（0x08008000）
  - 跳转函数：设置MSP→设置PC→禁用中断
- 应用程序中断向量表偏移：SCB->VTOR = 0x08008000
- **Keil工程同步修改**：Options → Target → IROM1起始地址0x08008000、Size 0x78000（480KB）——不改的话代码仍链接到0x08000000，Bootloader跳转后必然跑飞

#### 10.3 应用程序OTA功能
- MQTT订阅OTA主题："gateway/ota/gw001"
- 收到OTA指令（包含固件URL/大小/CRC）→进入OTA模式
- 通过HTTP或MQTT分片下载固件到W25Q64的新固件下载区
- 下载完成→校验CRC→写入升级标志→复位
- 复位后Bootloader自动完成固件更新

#### 10.4 回滚机制（v1.1重写：必须双槽才能真正回滚）
> 原方案只存一份新固件——新固件写入内部Flash后旧版本即被覆盖，"回滚"无从谈起。升级流程改为两步备份：
1. 下载新固件到W25Q64"新固件下载区"并校验CRC
2. **先把内部Flash当前应用整体备份到"旧固件备份区"**（备份自带CRC），再擦写内部Flash应用区
3. 新固件首次运行正常（联网成功+连续稳定运行N分钟）才置位"升级成功标志"
4. 新固件看门狗复位≥3次仍未确认 → Bootloader从"旧固件备份区"恢复旧版本；若旧备份区CRC也损坏，停在Bootloader等待串口重烧
> 进阶替代：利用内部Flash预留的0x08080000~0x080FFFFF做A/B双应用槽，Bootloader按标志选择启动槽位，连备份/恢复的整块拷贝都能省掉

**验证标准**：
- [ ] Bootloader能正常跳转到应用
- [ ] 应用能正常下载固件到W25Q64
- [ ] CRC校验正确
- [ ] 升级后新固件正常运行
- [ ] 升级失败（CRC错误）能回滚到旧版本
- [ ] 升级过程中断电不会变砖（Bootloader始终可用）

**注意**：OTA是本项目最复杂的功能，建议放在最后做。如果时间紧张，可以先做Bootloader+本地串口升级，网络OTA作为扩展。

---

### 阶段11：SD卡数据存储（可选，预计1天）

**目标**：历史数据存入SD卡文件，支持按天存储。

**操作步骤**：
1. 连接SD卡模块（SPI2共用，CS=PC6），插入FAT32格式的SD卡
2. 移植FatFS文件系统：
   - diskio.c：实现SD卡SPI读写底层
   - ff.c：FatFS核心
3. 实现：
   - `SD_Init()`：初始化SD卡，读取CID/CSD
   - `SD_SaveData(data)`：以追加方式写入当天文件（如"20260929.csv"）
   - CSV格式：`时间戳,温度,湿度\r\n`
4. 测试：采集数据同时写入SD卡，取出SD卡用电脑打开CSV确认数据

**验证标准**：
- [ ] SD卡识别成功，容量正确
- [ ] 文件创建成功
- [ ] 数据写入正确，CSV格式可被Excel打开
- [ ] 连续写入1000条无丢失
- [ ] 热插拔检测（可选）

---

### 阶段13：4G模块双链路（可选/高级，预计2天）

**目标**：以太网断开时自动切换4G上云。

**操作步骤**：
1. 连接Air780E（UART3：PB10/PB11），独立5V 2A供电，插入物联网SIM卡
2. 实现4G驱动（AT指令）：
   - `Air780E_Init()`：开机（PWR_KEY拉低2秒），等待开机
   - `Air780E_SendAT(cmd, timeout)`：发AT指令，等待回复
   - `Air780E_ConnectMQTT(broker, port, clientid)`：通过AT指令建立MQTT连接
   - `Air780E_Publish(topic, payload)`：发布消息
3. 双链路切换逻辑：
   - 优先使用W5500以太网
   - 以太网连续失败→切换4G
   - 以太网恢复→切回以太网（4G流量贵）
4. 注意：4G模块AT指令集需要参考合宙官方文档

**验证标准**：
- [ ] 4G模块能正常开机、注册网络
- [ ] 能通过4G建立MQTT连接
- [ ] 能发布数据
- [ ] 以太网/4G自动切换正常

---

## 第五部分：项目时间估算

| 阶段 | 内容 | 预计时间 | 累计 |
|---|---|---|---|
| 0 | 硬件验证点灯 | 0.5天 | 0.5天 |
| 1 | TFT屏显示 | 1天 | 1.5天 |
| 2 | DS1307 RTC | 0.5天 | 2天 |
| 3 | RS485 Modbus采集 | 1.5天 | 3.5天 |
| 4 | W25Q64 Flash读写 | 1天 | 4.5天 |
| 5 | W5500以太网 | 2天 | 6.5天 |
| 6 | MQTT上云 | 1.5天 | 8天 |
| 7 | 显示整合 | 0.5天 | 8.5天 |
| 8 | FreeRTOS多任务 | 3.5天 | 12天 |
| 9 | 断网缓存+补传 | 1.5天 | 13.5天 |
| 10 | OTA远程升级 | 5天 | 18.5天 |
| 11 | SD卡存储（可选） | 1天 | 19.5天 |
| 12 | CAN总线（可选） | 1天 | 20.5天 |
| 13 | 4G双链路（可选） | 2天 | 22.5天 |

> **核心功能（阶段0~9）**：约13.5天（v1.1上调：FreeRTOS整合与OTA是超期重灾区，各加1.5~2天）
> **完整功能（含可选）**：约22.5天
> **以上为全职投入、有STM32基础者的估算**；首次系统接触STM32建议整体按1.5~2倍预留。时间告急时优先保证阶段0~9完整闭环（RTOS整合+数据可靠性+OTA才是项目含金量主体），可选阶段11~13整段砍掉，但不要跳过任何阶段的验证标准

---

## 第六部分：调试工具与方法

### 一、必备调试手段

| 调试对象 | 工具/方法 | 用途 |
|---|---|---|
| 程序运行状态 | printf串口输出 | 打印变量值、函数进入/退出、错误码 |
| 通信数据 | USB转TTL/USB转RS485 + 串口助手 | 监听UART/RS485数据帧 |
| 网络通信 | Wireshark（电脑端抓包） | 分析TCP/MQTT数据包 |
| MQTT通信 | MQTT.fx | 模拟云端，收发消息 |
| 硬件信号 | 逻辑分析仪（见补购清单B2） | 分析SPI/I2C/CAN时序、RS485 DE/RE切换 |
| 电压测量 | 万用表 | 检查各模块供电是否正常 |
| 代码调试 | ST-Link + Keil Debug | 设断点、单步执行、查看寄存器和变量 |

### 二、通用调试流程

1. **先确认硬件**：用万用表测各模块VCC电压是否正确（3.3V/5V），GND是否共地
2. **再确认通信**：用USB转串口/逻辑分析仪监听数据，确认MCU发出的数据正确
3. **然后确认外设**：单独测试每个外设，确认能正常工作
4. **最后整合**：整合时如果出问题，回退到上一个能工作的版本，逐个模块排查

### 三、常见故障排查表

| 现象 | 可能原因 | 排查方法 |
|---|---|---|
| 程序下载后不运行 | BOOT0位置不对、复位电路、程序跑飞 | 检查BOOT0接GND、按复位键、串口看有无输出 |
| 串口无输出 | TX/RX接反、波特率不对、GND未共地 | 交叉TX/RX、确认波特率、测GND连通 |
| SPI设备无响应 | SPI模式不对、速率太高、CS时序 | 降低SPI速率到1MHz、确认Mode0/Mode3、用逻辑分析仪看CS |
| I2C设备无响应 | SDA/SCL接反、上拉电阻、地址错误 | 换线、加4.7K上拉、用I2C扫描程序找地址 |
| RS485收不到数据 | A/B接反、DE方向控制、波特率 | 交换A/B、检查DE时序、电脑端监听确认变送器有回复 |
| W5500连不上网 | 网线、IP配置、SPI通信 | Ping测试、检查PHY状态、降低SPI速率 |
| MQTT连接失败 | broker地址、网络、ClientID | 电脑端MQTT.fx测试同一broker、检查网络 |
| 系统死机 | 栈溢出、内存越界、优先级反转 | 关中断看是否还死、检查数组边界、uxTaskGetStackHighWaterMark |

---

## 附录：关键数据手册获取

| 器件 | 数据手册关键词 | 用途 |
|---|---|---|
| STM32F407VGT6 | RM0090 Reference Manual / Datasheet | 寄存器、外设、引脚 |
| W5500 | W5500 Datasheet / ioLibrary | 寄存器、Socket API |
| W25Q64 | W25Q64JV Datasheet | 指令集、时序 |
| DS1307 | DS1307 Datasheet | 寄存器、BCD格式 |
| ST7789/ST7735 | ST7789V Datasheet | 初始化命令、寄存器 |
| SP3485 | SP3485 Datasheet | 电气特性、DE/RE时序 |
| TJA1050 | TJA1050 Datasheet | 电气特性、CAN物理层 |
| Air780E | Air780E AT指令手册 | AT指令集 |
| 温湿度变送器 | 商家提供的寄存器地址表 | Modbus寄存器映射、换算公式 |

> **最重要**：温湿度变送器的寄存器表必须向商家索要，没有这个表无法正确解析数据。

---

*文档版本：v1.1 | 生成日期：2026-09-29 | 主控：STM32F407VGT6*
#（注：v1.0初稿由AI生成；v1.1经逐项技术复核修订——修正DS1307供电、TJA1050电平、SD卡容量说法、Flash分区止址、FreeRTOS队列设计与OTA回滚方案等，新增补购清单与CubeMX关键设置，修订处以v1.1标注）
