uiuiiii1/stm32f407-iot-gateway/标准库基础工程/工程说明.md

# 标准库基础工程说明

> 生成日期：2026-09-29 ｜ 芯片：STM32F407VGT6 ｜ 库：STM32F4xx_StdPeriph V1.8.0（官方）
> 已通过命令行编译验证：0 Error / 0 Warning，HEX 已生成

## 一、工程结构

```
标准库基础工程/
├── Start/          启动文件+CMSIS内核（startup_stm32f40_41xxx.s、system_stm32f4xx.c、core_cm4.h等）
├── Library/        标准库驱动（src/ 42个.c 已加入编译，inc/ 全部头文件）
├── Hardware/       板级驱动（lcd/i2c+ds1307[挂起]/modbus/spi2+w25q64/w5500_bsp）
├── Ethernet/       WIZnet ioLibrary（socket/wizchip_conf/W5500，硬件TCP/IP协议栈）
├── User/           用户代码（main.c、stm32f4xx_it.c、stm32f4xx_conf.h、stm32f4xx_it.h）
├── Objects/        编译输出（基础项目.axf / 基础项目.hex）
└── Listings/       编译清单
```

## 二、已配置项（不需要再动）

| 配置项 | 值 | 位置 |
|---|---|---|
| 芯片 | STM32F407VGTx | Options → Device |
| 宏定义 | `STM32F40_41xxx,USE_STDPERIPH_DRIVER` | Options → C/C++ → Define |
| 包含路径 | `.\Start;.\Library\inc;.\User` | Options → C/C++ → Include Paths |
| 编译器 | AC5（V5.06u7，与老库兼容最稳） | Options → Target |
| MicroLIB | 已勾选（printf 重定向依赖它） | Options → Target |
| HEX 输出 | 已勾选（FlyMcu 串口下载用） | Options → Output |
| 调试器 | ST-Link（uvoptx 已切换） | Options → Debug |
| 文件组 | Start / User / Hardware / Ethernet / Library（共78项，.h与.c成对） | 工程窗口 |

**已排除的库文件**：`stm32f4xx_fmc.c`（FMC 是 F427/429/439 专用控制器，F407 用 FSMC，此文件在 F407 配置下无法编译，故未加入编译组；文件仍在 Library/src 中）。

## 三、验证步骤（对应开发计划 阶段0）

1. 打开工程 → 按 F7 编译（应 0 错 0 警）
2. 下载：ST-Link 接 SWD 口 → 点 LOAD（F8）按钮
   - 首次使用 ST-Link：Options → Debug → Settings → Flash Download → 勾选 **Reset and Run**（下载后自动运行）
   - 没有调试器时：用 Objects/基础项目.hex + FlyMcu 串口 ISP 下载（BOOT0 接 3.3V → 复位 → 下载 → BOOT0 回 GND → 复位）
3. 预期现象（阶段3）：屏幕显示 Temp: xx.x C / Hum: xx.x %（2秒刷新，负温度带负号），串口 115200 收到 `System Start` 和周期性温湿度日志；读取失败显示红字 `MODBUS ERR`，串口给错误码（1=超时 2=CRC错 3=帧格式错），拔线不死机

## 四、✅ 晶振与板载资源（已按正确原理图 LXB407VG-P1 核实，2026-09-29）

原理图：`F:\于RTOS的多功能工业网关81059938718275\【4】原理图尺寸图\LXB407VG-P1原理图.pdf`；商家标准库例程在 `1781059938718275\【1】参考例程\标准库\`（LED/按键/串口/RTC/1.54寸屏/3.5寸屏，引脚已与例程 led.h 交叉验证一致）

- **主控 STM32F407VGT6**（1MB Flash / 192KB RAM），与开发计划一致
- **HSE = 8MHz（X1）**：已应用——Define 加了 `HSE_VALUE=8000000`，`PLL_M` 已改 8，系统时钟 168MHz
- **板载 32.768kHz RTC 晶振 + CR1220 纽扣电池**（VBAT）：内部 RTC 可掉电走时，**M6 DS1307 模块可以省掉**（省一条 I2C，精度还更好）
- **用户 LED = PC0**（LED2 蓝光，低电平点亮）；LED1 红光为电源指示灯常亮——main.c 已按此配置并与商家 led.h 交叉验证
- **用户按键 = PC1**（KEY）；**BOOT0 按键**：按住 BOOT0 再复位可进 ISP 串口下载模式
- **板上没有 W25QXX、没有 TF 卡座** → **M7 W25Q64 模块、M16 SD 模块照计划正常使用**
- **SPI 液晶座（FPC 8P，接 1.54寸屏）**：SPI3 PB3(SCK)/PB5(MOSI)，CS=PA15，DC=PD13，BL=PD12，RST 由板上 RC 电路硬件复位（不占 GPIO）——与计划"TFT 接 SPI3"一致，DC/BL 引脚按此修正（原计划 PC7/PC8/PC9 作废）
- **FSMC 液晶座（FPC 32P，3.5寸屏选配）**：8080 并口 + 电阻触摸**占用 SPI1（PA5/PA6/PA7）+ PB8/PB9**——**与阶段5 W5500（SPI1）冲突：接 W5500 时不要插 3.5寸触摸屏**
- **USB TypeC** 直连 PA11/PA12（支持 USB DFU 下载，可玩 USB 应用）
- IO 引出：2×21P 排针两排（PA13/PA14、PC14/PC15、晶振脚不引出）
- 供电：推荐 5V 进 TypeC 或 5V 引脚，板载 RY3420 DCDC 降压 3.3V

## 五、常见问题

| 现象 | 原因/处理 |
|---|---|
| 串口乱码 | 晶振不匹配（见第四节）或波特率没设 115200 |
| LED 不闪 | 检查下载是否成功、BOOT0 是否接 GND |
| 下载器识别不到 | 装 ST-Link 驱动；SWD 线序 SWDIO=PA13, SWCLK=PA14 |
| 想加自己的模块 | 建议在工程里加 Hardware 组，放 xxx.c/xxx.h，头文件加进 Include Paths |
| 屏幕背光亮但白屏/黑屏 | 检查 FPC 排线方向、屏幕型号是否 ST7789 240x240；SPI3 已按板载座固定（PB3/PB5+PA15/PD13/PD12），一般不用动 |
| LCD_DisplayDecimals 显示乱码 | MicroLIB 的 sprintf 不支持 %f——要显示小数需关 MicroLIB（Options→Target）或自行实现浮点转字符串 |

## 六、下一步

阶段0（串口）与阶段1（TFT屏）已合入本工程，按开发计划对应验证标准打勾后，进入阶段2（RTC——板载内部RTC可替代DS1307）或阶段3（RS485 Modbus）。加新外设驱动时：库的 .c 都已在工程里，只需 `#include "stm32f4xx_xxx.h"`（conf.h 已全开）即可调用。

## 七、阶段8/9 升级记录（2026-10-02，FreeRTOS + 断网缓存版）

本工程已从裸机版升级为 **FreeRTOS V11.3.0 多任务 + 断网缓存**版本（已编译 0错0警）：

- **FreeRTOS**：`FreeRTOS/` 内核 7 文件；`Start/FreeRTOSConfig.h`（168MHz/1kHz tick/48KB heap_4；**切勿定义 configSYSTICK_CLOCK_HZ**，会导致 tick 慢 8 倍）；`User/app.c/h`（5 任务：看门狗/采集/网络/存储/显示，互斥锁保护共享状态，IWDG+心跳巡检）；`Hardware/delay.c` RTOS 垫片；w5500_bsp 注册 CRIS 临界区回调
- **阶段9 断网缓存**：`Hardware/datalog.c/h`（W25Q64 环形缓存，分区 0x110000 起 7.25MB，32B/条 CRC16，懒擦除磨损均衡，消费进度存 AT24C64 双槽书签——阶段10 起，断电不丢）；`Hardware/sntp.c/h`（ntp.aliyun.com 对时，Socket3，DNS 复用）；`rtc.c` 增加 Unix 时间戳接口；数据流 COL→队列→STG→离线写 Flash→联网灌补传队列→NET 发布 `gateway/gw001/replay`
- **分区表（为阶段10 OTA 预留）**：Slot A 固件 512KB（0x000000）/ Slot B 固件 512KB（0x080000）/ 参数区 64KB（0x100000）/ 数据缓存 7.25MB（0x110000）
- 下方原始说明为早期裸机版配置，硬件接线与驱动部分仍然有效。

## 八、阶段10 OTA 升级记录（2026-10-06，v0.4 里程碑，已上板验收）

应用已搬至 **0x08008000**（Bootloader 在 0x08000000，独立工程 `F:\于RTOS的多功能工业网关\bootloader\`），OTA 全链路已验收：

- **AT24C64（软件 I2C，PB10/PB11）**：`Hardware/AT24C64.c/h`（掉电安全介质）+ `Hardware/at24c64_slot.c/h`（双槽状态接口，撕裂兜底）；datalog 书签后端 + 升级标志/计数/确认版本全放这里（`0x20` 升级标志、`0x23/0x24` 待确认计数、`0x30` 确认版本）
- **Bootloader**：`bootloader/` 独立工程；检测 AT24C64 升级标志 → W25Q64 Slot A 校验（元数据/向量表）→ 逐扇区擦写 0x08008000 + 读回比对 → 清标志跳转；W25 不在位驻留不跳；升级失败未擦应用区自动回退旧应用；A2 启动计数器（待确认 ≥3 次未确认串口告警）
- **应用侧 OTA**：`Hardware/ota.c/h`（MQTT 订阅 `gateway/gw001/cmd`、`gateway/gw001/ota`；JSON 解析/hex 解码/CRC32/60~90s 超时/乱序即中止）；下载→CRC→写升级标志→复位；新固件上线发 `{"ota":"ok","ver":".."}` + `OTA_NotifyAlive()` 清待确认
- **工具**：`gen_ota_msgs.py`（生成分块报文）、`ota_send.py`（paho-mqtt 发布，可指定 broker）、`start_broker.cmd`（本地 amqtt 测试 broker）、`ota_local.cmd`（一键发本地）；broker 模式在 `Hardware/mqtt.h` 的 `MQTT_LOCAL_BROKER` 快速切换（1=本地 192.168.0.106，0=公网 emqx.io）
- **固件版本**：`Hardware/ota.h` 的 `OTA_VER_STR/OTA_VER_CODE`（当前 0.5）
- **待办**：GitHub 发布 v0.4（交接其他 AI，见 `F:\于RTOS的多功能工业网关\交接-发布GitHub.md`）

## 九、阶段11 SD 卡归档升级记录（2026-10-07，已上板验收，SPL+HAL 双工程）

- **硬件**：MicroSD 模块（带 AMS1117 稳压，VCC 必须接 5V）+ 8GB 卡（**FAT32 格式**，exFAT 不支持）；**软件 SPI 专用总线**：CS=PC6 / SCK=PC7 / MISO=PC8 / MOSI=PC9（GPIO 位拍，模式0）——不与 W25Q64 共享 SPI2（原方案因 SD 模块 MISO 缓冲器常使能抢线废弃，踩坑 #40）；Init 期 400kHz、读写 2MHz（DWT 半位延时）
- **FatFS R0.12c**（本机 STM32Cube 仓库提取）：工程 `FatFs/`；ffconf：LFN 关/CP1/TINY/单写者（LOCK、REENTRANT 全 0）/**_USE_MKFS 0（板端格式化已禁用——不可分割长调用实测复位循环）**；`Hardware/diskio_sd.c` 桥接；get_fattime 用 RTC（无效回 2026-01-01）
- **挂载前介质预检（app.c，勿删）**：裸读扇区 0，EXFAT 魔数/无 FAT 类型分区/无 FAT 签名 → 拒绝挂载（R0.12c check_fs 的 JumpBoot 规则会误判，踩坑 #41）；**f_getfree 全项目禁用**（FSINFO 无效时全表扫描 ~75s 远超 IWDG）
- **归档模块 `Hardware/sdlog.c/h`**：按天 `YYYYMMDD.CSV`（8.3 短名），行格式 `unix,温度x10,湿度x10
`；文件常开+每 10 条 f_sync+跨天换文件；RTC 无效期写 NODATE.CSV；失败降级+60s 重探测；**只在 STG 任务调用（单写者）**；每 60s 打 `[SD] recs=N`
- **常驻自检**：金丝雀（STG 联网后写读一条缓存记录并消费，`[DL] canary online: OK`）+ DL_Append 写后回读探针（故障时打 hex+SR1，每上电限 2 次）——排查"静默写失败"（劣化网线注噪案，踩坑 #42）
- **验收**：SPL 四步（写入节奏/拔卡降级/插回恢复/断网并行）+ HAL 全绿；坏网线连环案（补传全灭三天）定案元凶=网线劣化，换线即愈
