uiuiiii1/stm32f407-iot-gateway/docs/LXB407VG-P1原理图.pdf

# 3V3电源电路 USB接口电路

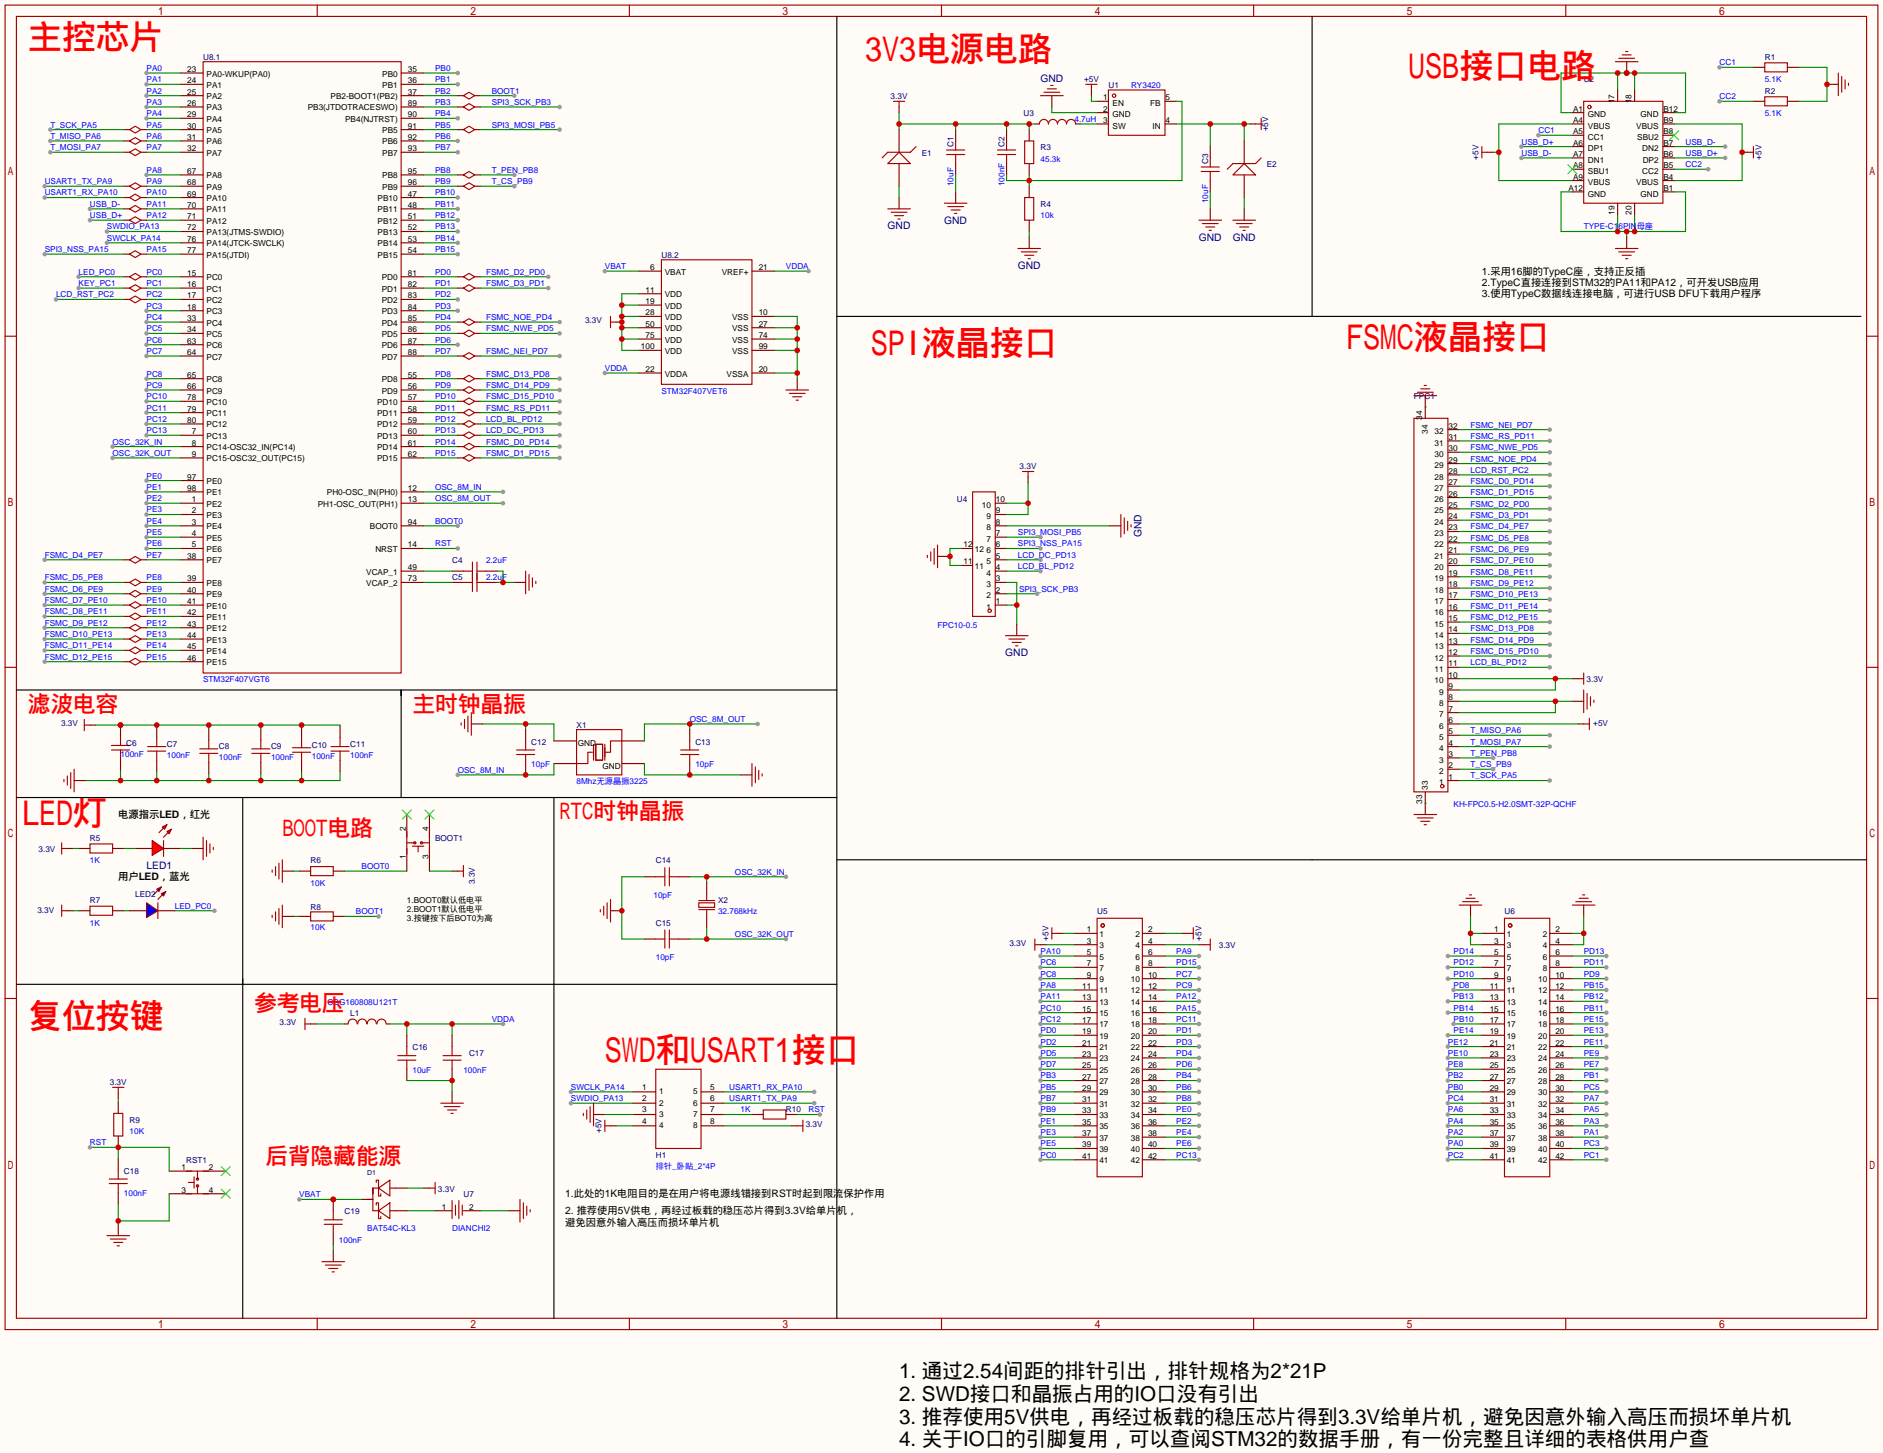
[picture p1: page 1]
