uiuiiii1/stm32f407-iot-gateway/HAL库工程/RTOS的多功能工业网关.ioc

Mcu.UserName=STM32F407VGTx
PA10.Signal=USART1_RX
PA13.Signal=SYS_JTMS-SWDIO
PA14.Signal=SYS_JTCK-SWCLK
PA15.GPIO_Label=LCD_CS
PA15.Signal=GPIO_Output
PA2.Signal=USART2_TX
PA3.Signal=USART2_RX
PA4.GPIO_Label=MB_DE
PA4.Signal=GPIO_Output
PA5.Signal=SPI1_SCK
PA6.Signal=SPI1_MISO
PA7.Signal=SPI1_MOSI
PA9.Signal=USART1_TX
PB3.Signal=SPI3_SCK
PB5.Signal=SPI3_MOSI
PC0.GPIO_Label=LED
PC0.Signal=GPIO_Output
PC14-OSC32_IN.Signal=RCC_OSC32_IN
PC15-OSC32_OUT.Signal=RCC_OSC32_OUT
PC4.GPIO_Label=W5500_CS
PC4.Signal=GPIO_Output
PC5.GPIO_Label=W5500_RST
PC5.Signal=GPIO_Output
PC6.GPIO_Label=SD_CS
PC6.Signal=GPIO_Output
PC7.GPIO_Label=SD_SCK
PC7.Signal=GPIO_Output
PC8.GPIO_Label=SD_MISO
PC8.Signal=GPIO_Input
PC9.GPIO_Label=SD_MOSI
PC9.Signal=GPIO_Output
PC10.Signal=USART3_TX
PC11.Signal=USART3_RX
PC12.GPIO_Label=4G_RDY
PC12.Signal=GPIO_Input
PD12.GPIO_Label=LCD_BL
PD12.Signal=GPIO_Output
PD13.GPIO_Label=LCD_DC
PD13.Signal=GPIO_Output
PE0.GPIO_Label=4G_RST
PE0.Signal=GPIO_Output
PH0-OSC_IN.Signal=RCC_OSC_IN
PH1-OSC_OUT.Signal=RCC_OSC_OUT
