uiuiiii1/stm32f407-iot-gateway/HAL库工程/Core/Src/main.c

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
/* Includes ------------------------------------------------------------------*/
#include "main.h"
#include "rtc.h"
#include "spi.h"
#include "usart.h"
#include "gpio.h"

/* USER CODE BEGIN Includes */
#include <stdio.h>
#include "stm32f4xx_it.h"   /* Fault_Blink：Error_Handler / 异常时的 LED 故障指示 */
#include "FreeRTOS.h"
#include "task.h"
#include "delay.h"
#include "usart_app.h"      /* USART1 调试串口 + printf 重定向 */
#include "lcd_spi_154.h"
#include "w5500_bsp.h"
#include "modbus.h"
#include "mqtt.h"
#include "rtc_app.h"
#include "AT24C64.h"
#include "ota.h"
#include "app.h"
/* USER CODE END Includes */


/* USER CODE BEGIN PV */
/* 阶段8：FreeRTOS 多任务。任务/共享状态/心跳全部在 app.c，
 * 本文件只负责外设初始化 -> APP_Init() -> 启动调度器。 */
/* USER CODE END PV */

void SystemClock_Config(void);
/* USER CODE BEGIN 0 */
/*
 * HAL 工程 —— 阶段8：FreeRTOS 多任务（与标准库版功能一致）
 * W5500 接线：SCLK=PA5 / MISO=PA6 / MOSI=PA7（SPI1），nSS=PC4，nRST=PC5
 * 网络：静态IP 192.168.0.250（见 w5500_bsp.h 配置区）；Modbus 变送器接 USART2（DE=PA4）
 *
 * SysTick 归属：HAL_Init 先按 1ms 配好（HAL_IncTick 时基），vTaskStartScheduler
 * 时由 port 重新配置为同频率 FreeRTOS tick；it.c 的 SysTick_Handler 链式调用
 * 两者（HAL_IncTick + xPortSysTickHandler），HAL_GetTick/HAL_Delay 全程可用，
 * 无需像 CubeMX 那样把 HAL 时基迁到 TIM6/7。
 */
/* USER CODE END 0 */

/**
  * @brief  The application entry point.
  * @retval int
  */
int main(void)
{

  /* USER CODE BEGIN 1 */
  /* 阶段10：应用从 0x08000000 搬到 0x08008000（bootloader 之后）：
   * 向量表重定位（bootloader 跳转前也会设，这里兜底） */
  SCB->VTOR = 0x08008000;
  /* 关键：bootloader 跳转前调过 __disable_irq()（PRIMASK=1），必须尽早恢复全局中断，
   * 否则调度器启动前 SysTick 中断被屏蔽 → uwTick 冻结 → HAL_Delay/HAL_GetTick 全部死等
   * （现象：System Start 打印后无声卡死，VECT_TAB_OFFSET 设了也没用） */
  __enable_irq();
  /* USER CODE END 1 */

  /* MCU Configuration--------------------------------------------------------*/

  /* Reset of all peripherals, Initializes the Flash interface and the Systick. */
  HAL_Init();

  /* Configure the system clock */
  SystemClock_Config();

  /* Initialize all configured peripherals */
  MX_GPIO_Init();
  RTC_Init_Wrap();   /* 开备份域写使能（DBP）：必须在 MX_RTC_Init 之前，阶段9 对时/书签依赖 */
  MX_RTC_Init();
  MX_SPI1_Init();
  MX_SPI3_Init();
  MX_USART1_UART_Init();
  MX_USART2_UART_Init();
  MX_USART3_UART_Init();   /* 阶段13：Air780E 4G 备份通道 USART3（PC10/PC11） */
  /* USER CODE BEGIN 2 */
  /* MX_GPIO_Init 按 .ioc 里的默认状态把 PD12 拉低了，这里立刻重新点亮背光 */
  LCD_Backlight_ON;

  /* 时钟/GPIO/SPI/USART/RTC 已由上面的 MX_xxx_Init 配好，这里只做应用层初始化 */
  Delay_Init();
  USART1_Init(115200);
  printf("System Start (FreeRTOS V11.3.0)\r\n");

  SPI_LCD_Init();

  LCD_SetAsciiFont(&ASCII_Font16);  LCD_SetBackColor(LCD_WHITE);
  LCD_SetColor(LCD_BLACK);
  LCD_Clear();
  LCD_ShowNumMode(Fill_Space);  /* 数字不足位补空格 */

  /* 仪表盘静态框架 */
  LCD_DisplayString(16, 16,  "Industrial Gateway");
  LCD_DisplayString(16, 40,  "Link:");
  LCD_DisplayString(16, 64,  "MQTT:");
  LCD_DisplayString(16, 92,  "Temp:");
  LCD_DisplayString(16, 116, "Hum :");
  LCD_DisplayString(112, 92,  "C");
  LCD_DisplayString(112, 116, "%");
  LCD_DisplayString(16, 144, "IP: 192.168.0.250");
  LCD_DisplayString(16, 168, "PUB:");

  MB_USART_Init();
  AT24C64_Init();      /* 阶段10：掉电安全状态介质（软件I2C），datalog 书签/OTA 状态 */
  W5500_BSP_Init();
  W5500_NetworkInit();
  MQTT_Init();
  printf("FW v%s (OTA)\r\n", OTA_VER_STR);
#if MQTT_LOCAL_BROKER
  printf("Gateway ready: IP 192.168.0.250, broker=LOCAL(192.168.0.105:1883), MQTT pub 5s\r\n");
#else
  printf("Gateway ready: IP 192.168.0.250, broker.emqx.io:1883, MQTT pub 5s\r\n");
#endif

  /* 创建互斥锁 + 4 任务（详见 app.c），随后交出控制权给 FreeRTOS */
  APP_Init();
  printf("Starting scheduler...\r\n");
  vTaskStartScheduler();

  /* 正常不会走到这里：走到 = 堆不足等致命错误 */
  printf("FATAL: scheduler start failed\r\n");
  /* USER CODE END 2 */

  /* Infinite loop */
  /* USER CODE BEGIN WHILE */
  while (1)
  {
    /* USER CODE END WHILE */

    /* USER CODE BEGIN 3 */
    /* 调度器已启动且不会返回，这里只是兜底 */
  }
  /* USER CODE END 3 */
}

/* ---------- FreeRTOS 钩子 ---------- */

void vApplicationMallocFailedHook(void)
{
  printf("FATAL: malloc failed\r\n");
  taskDISABLE_INTERRUPTS();
  for (;;);
}

void vApplicationStackOverflowHook(TaskHandle_t xTask, char *pcTaskName)
{
  (void)xTask;
  printf("FATAL: stack overflow in %s\r\n", pcTaskName ? pcTaskName : "?");
  taskDISABLE_INTERRUPTS();
  for (;;);
}

void vAssertCalled(const char *pcFile, int pcLine)
{
  printf("ASSERT: %s:%d\r\n", pcFile, pcLine);
  taskDISABLE_INTERRUPTS();
  for (;;);
}

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
