uiuiiii1/stm32f407-iot-gateway/HAL库工程/Core/Inc/main.h

#define LED_Pin GPIO_PIN_0
#define LED_GPIO_Port GPIOC
#define MB_DE_Pin GPIO_PIN_4
#define MB_DE_GPIO_Port GPIOA
#define W5500_CS_Pin GPIO_PIN_4
#define W5500_CS_GPIO_Port GPIOC
#define W5500_RST_Pin GPIO_PIN_5
#define W5500_RST_GPIO_Port GPIOC
#define LCD_BL_Pin GPIO_PIN_12
#define LCD_BL_GPIO_Port GPIOD
#define LCD_DC_Pin GPIO_PIN_13
#define LCD_DC_GPIO_Port GPIOD
#define LCD_CS_Pin GPIO_PIN_15
#define LCD_CS_GPIO_Port GPIOA
