uiuiiii1/stm32f407-iot-gateway/HAL库工程/Hardware/lcd_fonts.c

/****
	***********************************************************************************************************************************************************************************
	*	@file  	lcd_fonts.c
	*	@version V1.0
	*	@author  鹿小班科技
	*	@brief   字模数据，用户可自行添加或删减
   *****************************************************************************************************************************************************************************************************************************************
   *  @description
	*
	*	实验平台：鹿小班STM32F407VGT6核心板 （型号：LXB407VG-P1）
	*	客服微信：19949278543
	*
>>>>> 文件说明：
	*
	*	1.ASCII字符集: !"#$%&'()*+,-./0123456789:;<=>?@ABCDEFGHIJKLMNOPQRSTUVWXYZ[\]^_`abcdefghijklmnopqrstuvwxyz{|}~
	*	2.ASCII字模，总共有5种大小的字模：3216、2412、2010、1608、1206，皆是宋体
	*	3.中文字模也有五种大小：3232、2424、2020、1616、1212
	*	4.中文字库是小字库，也就是用到了相应的汉字再取模
	*	5.中文字库每个字模后面都必须要有一个对应的汉字作为索引
	*
>>>>> 取模方式说明：
	*
	*	1.取模软件 PCtolCD2018
	*	2.阴码、逆向、逐行式、C51格式。
	*
	*******************************************************************************************************************************************************************************************************************************************LXB*****
***/

#include "lcd_fonts.h"


// 汉字字模数据，字体为1212
// 添加新字模时，一定要不超过数组第一维的大小，用户可根据需求自行调整
//	中文标点符号和英文标点符号是不一样的！如果没有对中文标点符号进行取模，显示时要用英文输入标点，使用ASCII的字模
// 每个字模后面都必须要有一个对应的汉字作为索引
//
const uint8_t  Chinese_1212[20][24]=	
{                                                                                                                     
{0x40,0x00,0xFE,0x07,0x92,0x00,0xFE,0x07,0x92,0x04,0xFE,0x07,0x02,0x00,0x8A,0x04,0xBA,0x02,0x8A,0x01,0xAA,0x04,0x19,0x07},{"鹿 "},/*"鹿",0*/
{0x20,0x00,0x20,0x00,0x20,0x00,0x20,0x00,0x24,0x01,0x24,0x02,0x22,0x02,0x22,0x04,0x21,0x04,0x20,0x00,0x20,0x00,0x38,0x00},{"小 "},/*"小",1*/
{0x20,0x00,0xA7,0x07,0x22,0x01,0x2A,0x01,0x2A,0x01,0x2F,0x01,0xAA,0x07,0x26,0x01,0x22,0x01,0x16,0x01,0x13,0x01,0xC8,0x07},{"班 "},/*"班",2*/
{0x08,0x01,0x27,0x01,0x44,0x01,0x04,0x01,0x3F,0x01,0x44,0x01,0x0E,0x01,0x16,0x07,0xE5,0x01,0x04,0x01,0x04,0x01,0x04,0x01},{"科 "},/*"科",3*/
{0x84,0x00,0x84,0x00,0xF4,0x07,0x8F,0x00,0x84,0x00,0xF4,0x03,0x2C,0x02,0x27,0x02,0x44,0x01,0x84,0x00,0x44,0x01,0x36,0x06},{"技 "},/*"技",4*/
};

// 汉字字模数据，字体为1616
// 添加新字模时，一定要不超过数组第一维的大小，用户可根据需求自行调整
//	中文标点符号和英文标点符号是不一样的！如果没有对中文标点符号进行取模，显示时要用英文输入标点，使用ASCII的字模
// 每个字模后面都必须要有一个对应的汉字作为索引
//
const uint8_t  Chinese_1616[20][32]=	
{ 
                                                                                                                                                              
{0x80,0x00,0x00,0x01,0xFC,0x7F,0x44,0x04,0x44,0x04,0xFC,0x3F,0x44,0x24,0x44,0x24,0xFC,0x3F,0x14,0x02,0x14,0x22,0xF4,0x1A,0x12,0x06,0x12,0x22,0xD1,0x22,0x30,0x3C},{"鹿 "},/*"鹿",0*/
{0x80,0x00,0x80,0x00,0x80,0x00,0x80,0x00,0x80,0x00,0x88,0x08,0x88,0x10,0x88,0x20,0x84,0x20,0x84,0x40,0x82,0x40,0x81,0x40,0x80,0x00,0x80,0x00,0xA0,0x00,0x40,0x00},{"小 "},/*"小",1*/
{0x00,0x01,0x00,0x01,0x1F,0x7D,0x44,0x11,0x44,0x11,0x44,0x11,0x44,0x11,0x5F,0x7D,0x44,0x11,0x24,0x11,0x04,0x11,0x9C,0x10,0x87,0x10,0x42,0x7C,0x20,0x00,0x10,0x00},{"班 "},/*"班",2*/
{0x10,0x08,0xB8,0x08,0x0F,0x09,0x08,0x09,0x08,0x08,0xBF,0x08,0x08,0x09,0x1C,0x09,0x2C,0x08,0x0A,0x78,0xCA,0x0F,0x09,0x08,0x08,0x08,0x08,0x08,0x08,0x08,0x08,0x08},{"科 "},/*"科",3*/
{0x08,0x04,0x08,0x04,0x08,0x04,0xC8,0x7F,0x3F,0x04,0x08,0x04,0x08,0x04,0xA8,0x3F,0x18,0x21,0x0C,0x11,0x0B,0x12,0x08,0x0A,0x08,0x04,0x08,0x0A,0x8A,0x11,0x64,0x60},{"技 "},/*"技",4*/
};

// 汉字字模数据，字体为2020
// 添加新字模时，一定要不超过数组第一维的大小，用户可根据需求自行调整
//	中文标点符号和英文标点符号是不一样的！如果没有对中文标点符号进行取模，显示时要用英文输入标点，使用ASCII的字模
// 每个字模后面都必须要有一个对应的汉字作为索引
//
const uint8_t  Chinese_2020[20][60]=	
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
{0x00,0x00,0x00,0x00,0x00,0x00,0x00,0x00,0x80,0x00,0x10,0x00,0x80,0x03,0x70,0x00,0x80,0x01,0x30,0x00,0x80,0x01,0x30,0x00,0x80,0x01,0x30,0x00,0x80,0x01,0x30,0x00,0x80,0x19,0x30,0x18,0xFC,0xFF,0xFF,0x3F,0x80,0x01,0x30,0x00,0x80,0x01,0x30,0x00,0x80,0x01,0x30,0x00,0x80,0x01,0x30,0x00,0x80,0x31,0x30,0x04,0x80,0xCD,0xFF,0x0F,0x80,0x03,0x01,0x06,0xF0,0x01,0x01,0x06,0xBC,0x01,0x02,0x03,0x8C,0x01,0x02,0x03,0x80,0x01,0x86,0x01,0x80,0x01,0x84,0x01,0x80,0x01,0xCC,0x00,0x80,0x01,0x68,0x00,0x80,0x01,0x70,0x00,0x80,0x01,0x78,0x00,0x80,0x01,0xEC,0x00,0x80,0x01,0xC7,0x03,0xF8,0x81,0x01,0x1F,0xE0,0x71,0x00,0x3E,0x40,0x0C,0x00,0x00,0x00,0x00,0x00,0x00},{"技 "},/*"技",4*/
};


pFONT CH_Font12 = { Chinese_1212[0], 12, 12, 24  ,	sizeof(Chinese_1212)/sizeof(Chinese_1212[0]) };
pFONT CH_Font16 = { Chinese_1616[0], 16, 16, 32  ,	sizeof(Chinese_1616)/sizeof(Chinese_1616[0]) };
pFONT CH_Font20 = { Chinese_2020[0], 20, 20, 60  ,	sizeof(Chinese_2020)/sizeof(Chinese_2020[0]) };
pFONT CH_Font24 = { Chinese_2424[0], 24, 24, 72  ,	sizeof(Chinese_2424)/sizeof(Chinese_2424[0]) };
pFONT CH_Font32 = { Chinese_3232[0], 32, 32, 128 ,	sizeof(Chinese_3232)/sizeof(Chinese_3232[0]) };



/*********************************************************************************************************************************************************************************************************************************************LXB*****/
/*	
	*	1.以下为ASCII字模数据
	*	2.ASCII字符集: !"#$%&'()*+,-./0123456789:;<=>?@ABCDEFGHIJKLMNOPQRSTUVWXYZ[\]^_`abcdefghijklmnopqrstuvwxyz{|}~
	*	3.ASCII字模，宋体，总共有5种大小的字模：3216、2412、2010、1608、1206
*/
/*********************************************************************************************************************************************************************************************************************************************LXB*****/

const uint8_t ASCII_3216_Table [] = 
{
	0x00,0x00,0x00,0x00,0x00,0x00,0x00,0x00,0x00,0x00,0x00,0x00,0x00,0x00,0x00,0x00,0x00,0x00,0x00,0x00,0x00,0x00,0x00,0x00,0x00,0x00,0x00,0x00,0x00,0x00,0x00,0x00,0x00,0x00,0x00,0x00,0x00,0x00,0x00,0x00,0x00,0x00,0x00,0x00,0x00,0x00,0x00,0x00,0x00,0x00,0x00,0x00,0x00,0x00,0x00,0x00,0x00,0x00,0x00,0x00,0x00,0x00,0x00,0x00,/*" ",0*/
	0x00,0x00,0x00,0x00,0x00,0x00,0x00,0x00,0x00,0x00,0x00,0x00,0xC0,0x03,0xC0,0x03,0xC0,0x03,0xC0,0x03,0xC0,0x03,0xC0,0x03,0x80,0x03,0x80,0x01,0x80,0x01,0x80,0x01,0x80,0x01,0x80,0x01,0x80,0x01,0x80,0x01,0x80,0x01,0x00,0x00,0x00,0x00,0x00,0x00,0x80,0x01,0xC0,0x03,0xC0,0x03,0x80,0x01,0x00,0x00,0x00,0x00,0x00,0x00,0x00,0x00,/*"!",1*/
	0x00,0x00,0x00,0x00,0xC0,0x18,0xE0,0x1C,0xE0,0x1C,0x70,0x0E,0x30,0x06,0x18,0x03,0x8C,0x01,0x84,0x00,0x00,0x00,0x00,0x00,0x00,0x00,0x00,0x00,0x00,0x00,0x00,0x00,0x00,0x00,0x00,0x00,0x00,0x00,0x00,0x00,0x00,0x00,0x00,0x00,0x00,0x00,0x00,0x00,0x00,0x00,0x00,0x00,0x00,0x00,0x00,0x00,0x00,0x00,0x00,0x00,0x00,0x00,0x00,0x00,/*""",2*/
	0x00,0x00,0x00,0x00,0x00,0x00,0x00,0x00,0x00,0x00,0x00,0x00,0x20,0x10,0x20,0x10,0x20,0x10,0x20,0x10,0x20,0x10,0xFE,0x7F,0xFE,0x7F,0xFE,0x7F,0x10,0x08,0x10,0x08,0x10,0x08,0x10,0x08,0x10,0x08,0x10,0x08,0xFE,0x7F,0xFE,0x7F,0xFE,0x7F,0x18,0x0C,0x08,0x04,0x08,0x04,0x08,0x04,0x08,0x04,0x00,0x00,0x00,0x00,0x00,0x00,0x00,0x00,/*"#",3*/
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
	0                    // 该参数只有汉字字模用到，表示二维数组的行大小
};

pFONT ASCII_Font20 = {
	ASCII_2010_Table,		//	字模数组地址
	10,                  //	单个字符的字模宽度
	20,                  //	单个字符的字模长度
	40,                  //	单个字符的字模数据个数
	0                    // 该参数只有汉字字模用到，表示二维数组的行大小
};

pFONT ASCII_Font16 = {
	ASCII_1608_Table,		//	字模数组地址
	8,                   //	单个字符的字模宽度
	16,                  //	单个字符的字模长度
	16,                  //	单个字符的字模数据个数
	0                    // 该参数只有汉字字模用到，表示二维数组的行大小
};

pFONT ASCII_Font12 = {
	ASCII_1206_Table,		//	字模数组地址
	6,                   //	单个字符的字模宽度
	12,                  //	单个字符的字模长度
	12,                  //	单个字符的字模数据个数
	0                    // 该参数只有汉字字模用到，表示二维数组的行大小
};
