uiuiiii1/stm32f407-iot-gateway/bootloader/Hardware/usart.c

#include "usart.h"
#include <stdio.h>

/*
 * 调试串口驱动（USART1 + printf重定向）
 * 从 main.c 抽出（2026-09-30），供电同源改造后此模块与网络模块无任何电气耦合
 */

void USART1_Init(uint32_t baudrate)
{
    GPIO_InitTypeDef  GPIO_InitStructure;
    USART_InitTypeDef USART_InitStructure;

    RCC_AHB1PeriphClockCmd(RCC_AHB1Periph_GPIOA, ENABLE);
    RCC_APB2PeriphClockCmd(RCC_APB2Periph_USART1, ENABLE);

    /* PA9(TX)/PA10(RX)：复用推挽/复用输入 */
    GPIO_PinAFConfig(GPIOA, GPIO_PinSource9,  GPIO_AF_USART1);
    GPIO_PinAFConfig(GPIOA, GPIO_PinSource10, GPIO_AF_USART1);

    GPIO_InitStructure.GPIO_Pin   = GPIO_Pin_9 | GPIO_Pin_10;
    GPIO_InitStructure.GPIO_Mode  = GPIO_Mode_AF;
    GPIO_InitStructure.GPIO_OType = GPIO_OType_PP;
    GPIO_InitStructure.GPIO_Speed = GPIO_Speed_100MHz;
    GPIO_InitStructure.GPIO_PuPd  = GPIO_PuPd_UP;
    GPIO_Init(GPIOA, &GPIO_InitStructure);

    USART_InitStructure.USART_BaudRate            = baudrate;
    USART_InitStructure.USART_WordLength          = USART_WordLength_8b;
    USART_InitStructure.USART_StopBits            = USART_StopBits_1;
    USART_InitStructure.USART_Parity              = USART_Parity_No;
    USART_InitStructure.USART_HardwareFlowControl = USART_HardwareFlowControl_None;
    USART_InitStructure.USART_Mode                = USART_Mode_Rx | USART_Mode_Tx;
    USART_Init(USART1, &USART_InitStructure);

    USART_Cmd(USART1, ENABLE);
}

/* printf重定向到USART1（MicroLIB） */
int fputc(int ch, FILE *f)
{
    while (USART_GetFlagStatus(USART1, USART_FLAG_TXE) == RESET);
    USART_SendData(USART1, (uint8_t)ch);
    return ch;
}
