uiuiiii1/stm32f407-iot-gateway/(commit log)

2026-10-01 milestone A: bare-metal IoT gateway (Modbus RTU + W5500/MQTT + LCD dashboard)
    - STM32F407VGT6 + SPL V1.8.0 (standard peripheral library)
    - Modbus RTU master: temp/humidity over RS485 (USART2 + DE control, TC-flag timing)
    - W5500 hardware TCP/IP: WIZnet ioLibrary + BSP, TCP echo verified
    - Minimal MQTT 3.1.1 client (QoS0): CONNECT/PUBLISH/PINGREQ, keepalive 60s,
    DNS with static-IP fallback (broker.emqx.io), auto-reconnect >= 2s
    - LCD dashboard (1.54in ST7789): Link/MQTT/Temp/Hum/IP/PUB counter
    - F407 internal RTC (LSE onboard), replacing defective DS1307 module
    - Robustness: module-presence detect, config self-heal, link debounce,
    timeouts on every hardware wait (no infinite loops)
    - W25Q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
    [RTC诊断_main_阶段2复活.c, delay.c, delay.h, ds1307.c, ds1307.h, i2c.c, i2c.h]
2026-10-02 add HAL library port (CubeMX + STM32CubeF4 HAL), verified on hardware
    - same functionality as SPL project: Modbus RTU + W5500/MQTT + ST7789 dashboard
    - all custom code in USER CODE sections, CubeMX regeneration safe
    - trimmed CMSIS to F407-needed headers, no build artifacts committed
    - debug scaffolding removed after hardware bring-up
2026-10-02 milestone B-1: FreeRTOS V11.3.0 in both SPL and HAL projects, verified on hardware
    - 4 tasks (watchdog/Modbus collect/network MQTT/LCD display) + mutex-guarded shared state
    - SPL: FreeRTOSConfig.h in Start/, app.c/h in User/, delay shim, ioLibrary CRIS callbacks
    - HAL: chained SysTick handler keeps HAL timebase alive (no TIM6/7 needed),
    FreeRTOSConfig.h in Core/Inc, app.c/h in Core
    - pitfall fixed: defining configSYSTICK_CLOCK_HZ made tick run at 125Hz (8x slow),
    MQTT keepalive missed and kicked by broker - define removed, documented
    - IWDG watchdog + per-task heartbeat monitoring, stack overflow / assert hooks
    [app.c, delay.c, delay.h, main.c, w5500_bsp.c, w5500_bsp.h]
2026-10-03 docs: SPL project doc updated for FreeRTOS + offline-cache stages
2026-10-04 feat(stage9): offline data cache with SNTP sync and MQTT replay (SPL + HAL)
    - SNTP time sync (ntp.aliyun.com with IP fallback) feeds record timestamps
    - W25Q64 ring cache: 32B records + CRC16, lazy erase, wear-leveled sectors,
    dual firmware slots + param area reserved for future OTA
    - offline caching -> auto replay to gateway/gw001/replay after reconnect
    - consume bookmark kept in RTC backup registers (survives reset)
    - storage task + data/replay queues; watchdog heartbeat over all tasks
    - board-tested fixes: SysTick 8x-slow tick config, watchdog self-lockout,
    heartbeat before continue paths, record serialization via explicit byte
    packing, empty-cache sector-drop underflow + EMI glitch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
    [app.c, datalog.c, datalog.h, main.c, modbus.c, mqtt.h, rtc.c, rtc.h]
2026-10-06 feat(stage10): OTA remote firmware upgrade with bootloader (SPL + HAL)
    - standalone bootloader (32KB @ 0x08000000): Slot A verify/flash, Slot B
    backup with automatic rollback, pending-confirm boot counter
    - both apps relocated to 0x08008000 (IROM + VTOR + VECT_TAB_OFFSET)
    - ota.c: MQTT chunked download (512B, out-of-order abort), CRC32 verify,
    dual-slot upgrade flag commit on AT24C64, version confirm publish
    - mqtt.c: SUBSCRIBE + downstream message pump + msg callback,
    non-blocking TCP connect polling, 3-strike send-fail reconnect limit
    - AT24C64 software I2C (PB10/PB11) + dual-slot bookmark/bookkeeping
    (signed seq compare, 30s write throttle, forced commit at drain end)
    - datalog: b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
    [AT24C64.c, AT24C64.h, app.c, at24c64_slot.c]
2026-10-07 feat(stage11+13): SD card daily CSV archive (FatFS) + Air780E 4G backup link (SPL + HAL)
    - SD card on dedicated bit-bang SPI bus (PC6~9), FatFS R0.12c, per-day
    YYYYMMDD.CSV, open-file + periodic f_sync, auto degrade/recover on
    card removal; datalog W25Q64 cache chain unaffected
    - Air780E 4G backup channel (Luat AT firmware, MQTT M-commands):
    Ethernet-down takeover/publish, auto switch-back, RST (PE0, open-drain)
    hard-reset self-heal with retry throttle, AT echo/CSQ/CGATT diagnostics,
    heartbeat callback, LCD tri-state display
    - CAN driver skeleton retained (PB8/9, not enabled)
    - README: stage 11/13 sections, roadmap, pitfall notes; gitignore hardening
    [RTOS的多功能工业网关.ioc, air780e.c, air780e.h, app.c, datalog.c, diskio_sd.c, main.c, mqtt.h]
2026-10-07 chore: remove unused CAN driver skeleton (never enabled on hardware)
2026-10-08 docs: drop optional CAN stage from development plan
