uiuiiii1/stm32f407-iot-gateway/(notices)

Notices in the files:
HAL库工程/Ethernet/W5500/w5500.c:
Copyright (c) 2013, WIZnet Co., LTD. All rights reserved.
HAL库工程/Core/Src/main.c:
Copyright (c) 2026 STMicroelectronics.
All rights reserved.
This software is licensed under terms that can be found in the LICENSE file
